OpenNuvoton/NuMaker_NuWicam_RDK/hardware_design/BOM/NUWICAM DEBUG BOM X 100.xls

NuWicam Debug BOM X 100
Item | Quantity | Reference | Part | Total
1 | 2 | C9,C8 | 20pF / 0603 | 200
2 | 1 | CB1 | 0.1uF / 0603 | 100
3 | 5 | C3,C5,C7,C10,C11 | 1uF / 0603 | 500
4 | 2 | C6,C4 | 10uF / 0603 | 200
5 | 2 | D2,D1 | RB161M-20 / SOD123 | 200
6 | 2 | R2,R4 | 0 / 0603 | 200
7 | 2 | R7,R8 | 27 / 0603 | 200
8 | 1 | R6 | 4.7K / 0603 | 100
9 | 1 | R5 | 10K / 0603 | 100
10 | 1 | R1 | 20K / 0603 | 100
11 | 1 | R3 | 39K / 0603 | 100
12 | 1 | J1 | HEADER 2X1 / 2.0mm_M | 100
13 | 1 | CON3 | HEADER 4X2 / 2.0mm_M | 100
14 | 2 | CON2,CON4 | USB-MINI-AB-RECEP. / SMD | 200
15 | 1 | U1 | NUC123ZD4AN0 / QFN33_5X5 | 100
16 | 1 | U2 | XC6206P332MR / SOT23 | 100
17 | 1 | X1 | 12MHz / TXC7m-3.2x2.5mm | 100
 | 15 |  |  | 1500
