OpenNuvoton/NuMaker_NuWicam_RDK/hardware_design/BOM/NUWICAM TVP BOM X 50.xls

NuWicam TVP BOM X 50
Item | Quantity | Reference | Part | Total
1 | 1 | C22 | 10pF / 0402 | 50
2 | 2 | C5,C6 | 12pF / 0402 | 100
3 | 2 | C21,C20 | 27pF / 0402 | 100
4 | 1 | C19 | 102pF / 0402 | 50
5 | 1 | C13 | 470pF / 0402 | 50
6 | 13 | CB1,C1,CB2,C2,CB3,C8,C9, | 0.1uF / 0402 | 650
 |  | C14,C15,C16,C17,C18,C25
7 | 6 | C7,CT8,C10,C11,C12,C4 | 1uF / 0402 | 300
8 | 14 | CT1,CT2,CT3,CT4,CT6,CT7, | 10uF / 0603 | 700
 |  | CT9,CT10,CT11,CT12,CT13,
 |  | CT14,CT15,CT16
9 | 6 | CT5 | 47uF / 0805 | 300
10 | 1 | LED1 | Ready LED / 0603 (Green) | 50
11 | 1 | LED2 | Link LED / 0603 (Red) | 50
12 | 1 | LED3 | Reserve LED / 0603 (Yellow) | 50
13 | 7 | L1,L4,L5,L6,L7,L8,L9 | FB / 0402 /10ohm 1A | 350
14 | 2 | L2,L3 | 4.7uH/1.1MHz / SMD | 100
15 | 3 | R32,R33,R17 | 0 / 0402 | 150
16 | 2 | R24,R30 | 22 / 0402 | 100
17 | 1 | R34 | 27 / 0402 | 50
18 | 1 | R23 | 47 / 0402 | 50
19 | 4 | R1,R2,R3,R10 | 1K / 0402 | 200
20 | 2 | R19,R20 | 1.2K / 0402 | 100
21 | 2 | R11,R15 | 3.3K / 0402 | 100
22 | 3 | R27,R31,R29 | 10K / 0402 | 150
23 | 1 | R13 | 12.1K 1% / 0402 | 50
24 | 1 | R9 | 47K / 0402 | 50
25 | 5 | R4,R5,R28,R12,R18 | 100K 1% / 0402 | 250
26 | 1 | R22 | 120K 1% / 0402 | 50
27 | 1 | R25 | 200K 1% / 0402 | 50
28 | 1 | R21 | 510K 1% / 0402 | 50
29 | 2 | R26,R8 | 1M / 0402 | 100
30 | 1 | J1 | RCA JACK | 50
31 | 1 | J2 | HEADER 2X1 / 2.0mm_M | 50
32 | 1 | CON1 | HEADER 4X1 / 2.54mm_M | 50
33 | 1 | CON2 | HEADER 4X2 / 2.0mm_F | 50
34 | 1 | SW1 | TPS-056 / SMD | 50
35 | 1 | ANT1 | IPEX_Connector / SMD | 50
36 | 1 | M1 | Microphone / 9.7D_2.54mm | 50
37 | 1 | Q1 | 2N3904 / SOT23-BEC | 50
38 | 1 | Q2 | SI2301CDS / SOT23-BEC | 50
39 | 1 | U1 | EN25Q64 / SOIC8 | 50
40 | 1 | U2 | N32905R3DN / TQFP64(EPAD) | 50
41 | 2 | U5,U3 | ZT7103T / TSOT-25 | 100
42 | 1 | U6 | RTL8189FTV / LGA_12mmx12mmx2mm | 50
43 | 1 | U4 | TVP5150 / LQFP32_7mmx7mm | 50
45 | 1 | X1 | 12MHz / TXC7m-3.2x2.5mm | 50
46 | 1 | X2 | 14.318MHz / TXC7m-3.2x2.5mm | 50
 | 58 |  |  | 2900
