OpenNuvoton/NuMaker_NuWicam_RDK/hardware_design/BOM/NUWICAM VGA BOM X 50.xls

NuWicam VGA BOM X 50
Item | Quantity | Reference | Part | Total
1 | 1 | C13 | 10pF / 0402 | 50
2 | 2 | C5,C6 | 12pF / 0402 | 100
3 | 1 | C12 | 102pF / 0402 | 50
4 | 1 | C10 | 470pF / 0402 | 50
5 | 9 | CB1,C1,CB2,C2,CB3,CB4,C8, | 0.1uF / 0402 | 450
 |  | C9,C11
6 | 3 | C7,CT8,C4 | 1uF / 0402 | 150
7 | 13 | CT1,CT2,CT3,CT4,CT6,CT7, | 10uF / 0603 | 650
 |  | CT9,CT10,CT11,CT12,CT13,
 |  | CT14,CT15
8 | 1 | CT5 | 47uF / 0805 | 50
9 | 1 | LED1 | Ready LED / 0603 (Green) | 50
10 | 1 | LED2 | Link LED / 0603 (Red) | 50
11 | 1 | LED3 | Reserve LED / 0603 (Yellow) | 50
12 | 5 | L1,L4,L5,L6,L7 | FB / 0402 /10ohm 1A | 250
13 | 2 | L2,L3 | 4.7uH/1.1MHz / SMD | 100
14 | 1 | R27 | 0 / 0402 | 50
15 | 2 | R20,R26 | 22 / 0402 | 100
16 | 4 | R1,R2,R3,R10 | 1K / 0402 | 200
17 | 2 | R21,R22 | 1.2K / 0402 | 100
18 | 2 | R15,R11 | 3.3K / 0402 | 100
19 | 1 | R25 | 10K / 0402 | 50
20 | 1 | R13 | 12.1K 1% / 0402 | 50
21 | 1 | R8 | 47K / 0402 | 50
22 | 5 | R4,R5,R24,R12,R17 | 100K 1% / 0402 | 250
23 | 1 | R19 | 120K 1% / 0402 | 50
24 | 1 | R23 | 200K 1% / 0402 | 50
25 | 1 | R18 | 510K 1% / 0402 | 50
26 | 1 | R9 | 1M / 0402 | 50
27 | 1 | CON1 | HEADER 4X1 / 2.54mm_M | 50
28 | 1 | CON2 | HEADER 4X2 / 2.0mm_F | 50
29 | 1 | SW1 | PTS-056 / SMD | 50
30 | 1 | ANT1 | IPEX_Connector / SMD | 50
31 | 1 | M1 | Microphone / 9.7D_2.54mm | 50
32 | 1 | Q1 | 2N3904 / SOT23-BEC | 50
33 | 1 | Q2 | SI2301CDS / SOT23-BEC | 50
34 | 1 | U1 | EN25Q64 / SOIC8 | 50
35 | 1 | U2 | N32905R3DN / TQFP64(EPAD) | 50
36 | 1 | U3 | FPC24_0.5mm | 50
37 | 2 | U4,U5 | ZT7103T / TSOT-25 | 100
38 | 1 | U6 | RTL8189FTV / LGA_12mmx12mmx2mm | 50
39 | 1 | X1 | 12MHz / TXC7m-3.2x2.5mm | 50
 | 47 |  |  | 2350
