OpenNuvoton/NuMaker_NuWicam_RDK/hardware_design/SMD_XY/NUCAM TVP_162.xls

PartType | RefDes | PartDecal | Pins | Layer | Orient. | X | Y | SMD | Glued
20279-001E-01 | ANT1 | ANT_3X3MM | 3 | Top | 90 | 155 | -150 | Yes | No
C0402 | C1 | C0402 | 2 | Top | 90 | 543.75 | -875 | Yes | No
C0402 | C2 | C0402 | 2 | Top | 270 | 284.4 | -1387.057 | Yes | No
C0402 | C4 | C0402 | 2 | Top | 270 | 762.102 | -1460.571 | Yes | No
C0402 | C5 | C0402 | 2 | Bottom | 90 | 481.25 | -675 | Yes | No
C0402 | C6 | C0402 | 2 | Bottom | 270 | 582 | -659.5 | Yes | No
C0402 | C7 | C0402 | 2 | Bottom | 0 | 900 | -1330 | Yes | No
C0402 | C8 | C0402 | 2 | Bottom | 90 | 858 | -1710 | Yes | No
C0402 | C9 | C0402 | 2 | Bottom | 90 | 810 | -1710 | Yes | No
C0402 | C10 | C0402 | 2 | Top | 0 | 212.5 | -1150 | Yes | No
C0402 | C11 | C0402 | 2 | Top | 0 | 212.5 | -1100 | Yes | No
C0402 | C12 | C0402 | 2 | Top | 90 | 284 | -1125 | Yes | No
C0402 | C13 | C0402 | 2 | Top | 90 | 737.5 | -631.25 | Yes | No
C0402 | C14 | C0402 | 2 | Top | 90 | 931.25 | -743.75 | Yes | No
C0402 | C15 | C0402 | 2 | Top | 0 | 268.75 | -1200 | Yes | No
C0402 | C16 | C0402 | 2 | Top | 90 | 281.25 | -1493.75 | Yes | No
C0402 | C17 | C0402 | 2 | Top | 0 | 410 | -1325 | Yes | No
C0402 | C18 | C0402 | 2 | Top | 90 | 485 | -875 | Yes | No
C0402 | C19 | C0402 | 2 | Bottom | 90 | 384 | -420 | Yes | No
C0402 | C20 | C0402 | 2 | Top | 90 | 396.9 | -1474.557 | Yes | No
C0402 | C21 | C0402 | 2 | Top | 270 | 618.75 | -1475 | Yes | No
C0402 | C22 | C0402 | 2 | Top | 0 | 335 | -150 | Yes | No
C0402 | C23 | C0402 | 2 | Top | 270 | 260 | -175 | Yes | No
C0402 | C24 | C0402 | 2 | Top | 270 | 410 | -175 | Yes | No
C0402 | C25 | C0402 | 2 | Bottom | 0 | 846 | -516 | Yes | No
C0402 | CB1 | C0402 | 2 | Bottom | 270 | 365.65 | -1468.307 | Yes | No
C0402 | CB2 | C0402 | 2 | Bottom | 90 | 684.4 | -812.057 | Yes | No
C0402 | CB3 | C0402 | 2 | Bottom | 180 | 825 | -987.5 | Yes | No
2.54MM_HEADER_1X4 | CON1 | SIP-4P | 4 | Top | 270 | 62.5 | -1190 | No | No
2.0MM_HEADER_2X4 | CON2 | HEADER4X2/2.0MM | 8 | Top | 270 | 87.5 | -775 | No | No
C0603 | CT1 | C0603 | 2 | Top | 90 | 636 | -864 | Yes | No
C0603 | CT2 | C0603 | 2 | Bottom | 270 | 428.15 | -1474.557 | Yes | No
C0603 | CT3 | C0603 | 2 | Bottom | 90 | 138 | -1158 | Yes | No
C0603 | CT4 | C0603 | 2 | Bottom | 180 | 837.5 | -1075 | Yes | No
C0805 | CT5 | C0805 | 2 | Top | 180 | 840 | -1615 | Yes | No
C0603 | CT6 | C0603 | 2 | Top | 90 | 210 | -870 | Yes | No
C0603 | CT7 | C0603 | 2 | Bottom | 90 | 850 | -1170 | Yes | No
C0402 | CT8 | C0402 | 2 | Bottom | 270 | 162.5 | -1268.75 | Yes | No
C0603 | CT9 | C0603 | 2 | Top | 0 | 875 | -606.25 | Yes | No
C0603 | CT10 | C0603 | 2 | Top | 0 | 868.75 | -1012.5 | Yes | No
C0603 | CT11 | C0603 | 2 | Bottom | 270 | 132 | -390 | Yes | No
C0603 | CT12 | C0603 | 2 | Bottom | 0 | 268.75 | -668.75 | Yes | No
C0603 | CT13 | C0603 | 2 | Top | 90 | 390 | -366 | Yes | No
C0603 | CT14 | C0603 | 2 | Top | 180 | 670 | -1255 | Yes | No
C0603 | CT15 | C0603 | 2 | Top | 180 | 265 | -1260 | Yes | No
C0603 | CT16 | C0603 | 2 | Bottom | 0 | 845 | -447 | Yes | No
RCA-JACK1 | J1 | RCA-JACK1 | 4 | Top | 270 | 312.5 | -1637.5 | No | No
2.0MM | J2 | HEADER2/2.0MM | 2 | Top | 0 | 666 | -1602 | No | No
L0402 | L1 | L0402 | 2 | Bottom | 270 | 920 | -1205 | Yes | No
SMTDR43 | L2 | SMTDR43 | 2 | Top | 270 | 868.75 | -900 | Yes | No
SMTDR43 | L3 | SMTDR43 | 2 | Bottom | 270 | 243.75 | -556.25 | Yes | No
L0402 | L4 | L0402 | 2 | Top | 270 | 700 | -1335 | Yes | No
L0402 | L5 | L0402 | 2 | Top | 180 | 235 | -1315 | Yes | No
L0402 | L6 | L0402 | 2 | Top | 180 | 300 | -378 | Yes | No
L0402 | L7 | L0402 | 2 | Bottom | 90 | 920 | -1110 | Yes | No
L0402 | L8 | L0402 | 2 | Bottom | 90 | 747 | -1614 | Yes | No
L0402 | L9 | L0402 | 2 | Top | 90 | 942 | -1524 | Yes | No
LED_0603 | LED1 | LED_0603 | 2 | Top | 270 | 362.5 | -600 | Yes | No
LED_0603 | LED2 | LED_0603 | 2 | Top | 270 | 288 | -600 | Yes | No
LED_0603 | LED3 | LED_0603 | 2 | Top | 270 | 216 | -600 | Yes | No
5.5D2.54MM | M1 | 9.7D2.54MM | 2 | Top | 180 | 834 | -1788 | No | No
SOT23-BCE | Q1 | SOT23 | 3 | Bottom | 90 | 852 | -1458 | Yes | No
SOT-23-GSD | Q2 | SOT23-GSD | 3 | Top | 0 | 84 | -1032 | Yes | No
R0402 | R1 | R0402 | 2 | Top | 270 | 362.5 | -481.25 | Yes | No
R0402 | R2 | R0402 | 2 | Top | 270 | 281.25 | -481.25 | Yes | No
R0402 | R3 | R0402 | 2 | Top | 270 | 200 | -481.25 | Yes | No
R0402 | R4 | R0402 | 2 | Top | 270 | 170 | -1340 | Yes | No
R0402 | R5 | R0402 | 2 | Top | 270 | 234.4 | -1387.057 | Yes | No
R0402 | R8 | R0402 | 2 | Top | 0 | 525 | -762.5 | Yes | No
R0402 | R9 | R0402 | 2 | Top | 90 | 816 | -1452 | Yes | No
R0402 | R10 | R0402 | 2 | Top | 270 | 942 | -1614 | Yes | No
R0402 | R11 | R0402 | 2 | Bottom | 270 | 906 | -1710 | Yes | No
R0402 | R12 | R0402 | 2 | Bottom | 180 | 900 | -1280 | Yes | No
R0402 | R13 | R0402 | 2 | Top | 270 | 725 | -862.5 | Yes | No
R0402 | R15 | R0402 | 2 | Bottom | 90 | 762 | -1710 | Yes | No
R0402 | R17 | R0402 | 2 | Top | 180 | 243.75 | -1056.25 | Yes | No
R0402 | R18 | R0402 | 2 | Top | 90 | 881.25 | -743.75 | Yes | No
R0402 | R19 | R0402 | 2 | Top | 270 | 435 | -870 | Yes | No
R0402 | R20 | R0402 | 2 | Top | 270 | 385 | -870 | Yes | No
R0402 | R21 | R0402 | 2 | Top | 90 | 787.5 | -631.25 | Yes | No
R0402 | R22 | R0402 | 2 | Top | 270 | 687.5 | -637.5 | Yes | No
R0402 | R23 | R0402 | 2 | Top | 270 | 231.25 | -1487.5 | Yes | No
R0402 | R24 | R0402 | 2 | Top | 0 | 271.9 | -999.557 | Yes | No
R0402 | R25 | R0402 | 2 | Bottom | 270 | 330 | -420 | Yes | No
R0402 | R26 | R0402 | 2 | Top | 0 | 509.4 | -1349.557 | Yes | No
R0402 | R27 | R0402 | 2 | Bottom | 90 | 666 | -1524 | Yes | No
R0402 | R28 | R0402 | 2 | Top | 180 | 210 | -378 | Yes | No
R0402 | R29 | R0402 | 2 | Top | 270 | 420 | -531 | Yes | No
R0402 | R30 | R0402 | 2 | Top | 270 | 418.75 | -737.5 | Yes | No
R0402 | R31 | R0402 | 2 | Top | 270 | 700 | -1175 | Yes | No
R0402 | R32 | R0402 | 2 | Top | 180 | 625 | -1315 | Yes | No
R0402 | R33 | R0402 | 2 | Top | 270 | 324 | -306 | Yes | No
R0402 | R34 | R0402 | 2 | Top | 270 | 335 | -1495 | Yes | No
PTS-056 | SW1 | SW4\3.5X3.55MM | 7 | Top | 270 | 915 | -1371 | No | No
SOIC8_208MIL | U1 | SOIC-8P_208MIL | 8 | Bottom | 270 | 862.5 | -762.5 | Yes | No
LQFP64_EPAD | U2 | QFP64/12/0.5MM/EP | 69 | Bottom | 180 | 484.4 | -1112.057 | Yes | No
TSOT-23-5 | U3 | TSOT-25 | 5 | Top | 0 | 793.75 | -743.75 | Yes | No
LQFP32_7X7 | U4 | PQFP-32 | 32 | Top | 90 | 484.4 | -1112.057 | Yes | No
TSOT-23-5 | U5 | TSOT-25 | 5 | Bottom | 0 | 237.5 | -400 | Yes | No
LGA_12X12X1.8 | U6 | LGA44_12_12MM | 45 | Top | 0 | 692.5 | -293.504 | Yes | No
QFN32_5X5 | U7 | GM7150-QFN32-5X5 | 33 | Top | 0 | 484.4 | -1112.057 | Yes | No
TXC7M-3.2X2.5MM | X1 | SMD3225 | 4 | Top | 0 | 525 | -668.75 | Yes | No
TXC7M-3.2X2.5MM | X2 | SMD3225 | 4 | Top | 0 | 509.4 | -1474.557 | Yes | No
