OpenNuvoton/NuMaker_NuWicam_RDK/hardware_design/SMD_XY/NUWICAM DEBUG.xls

PartType | RefDes | PartDecal | Pins | Layer | Orient. | X | Y | SMD | Glued
C0603 | C1 | C0603 | 2 | Top | 270 | 270 | 300 | Yes | No
C0603 | C2 | C0603 | 2 | Top | 90 | 480 | 300 | Yes | No
C0603 | C3 | C0603 | 2 | Top | 180 | 485 | 120 | Yes | No
C0603 | C4 | C0603 | 2 | Bottom | 180 | 487.5 | 150 | Yes | No
C0603 | C5 | C0603 | 2 | Top | 270 | 706.25 | 241.25 | Yes | No
C0603 | C6 | C0603 | 2 | Top | 270 | 631.25 | 241.25 | Yes | No
C0603 | C7 | C0603 | 2 | Top | 270 | 785 | 365 | Yes | No
C0603 | C8 | C0603 | 2 | Bottom | 180 | 962.5 | 185 | Yes | No
C0603 | C9 | C0603 | 2 | Bottom | 0 | 962.5 | 441.25 | Yes | No
C0603 | C10 | C0603 | 2 | Bottom | 90 | 1182 | 672 | Yes | No
C0603 | C11 | C0603 | 2 | Bottom | 270 | 960 | 678 | Yes | No
C0603 | CB1 | C0603 | 2 | Top | 180 | 956.25 | 397.5 | Yes | No
CONS/5X1/2.54 | CON1 | SIP-5P | 5 | Bottom | 0 | 912.5 | 50 | Yes | No
MINI_5P_B_TYPE | CON2 | MINI_5P_B_TYPE | 11 | Top | 0 | 415 | 485 | No | No
2.0MM_HEADER_2X4_A | CON3 | HEADER4X2/2.0MM_A | 8 | Bottom | 270 | 1161.417 | 393.701 | No | No
MINI_5P_B_TYPE | CON4 | MINI_5P_B_TYPE | 11 | Bottom | 270 | 306.25 | 81.25 | No | No
SOD-123 | D1 | MLL34 | 2 | Bottom | 0 | 243.75 | 712.5 | Yes | No
SOD-123 | D2 | MLL34 | 2 | Top | 180 | 270 | 85 | Yes | No
2.0MM | J1 | HEADER2/2.0MM | 2 | Top | 270 | 660 | 714 | No | No
R0603 | R1 | R0603 | 2 | Bottom | 180 | 395 | 710 | Yes | No
R0603 | R2 | R0603 | 2 | Top | 270 | 410 | 300 | Yes | No
R0603 | R3 | R0603 | 2 | Bottom | 180 | 395 | 635 | Yes | No
R0603 | R4 | R0603 | 2 | Top | 270 | 340 | 300 | Yes | No
R0603 | R5 | R0603 | 2 | Top | 270 | 785 | 240 | Yes | No
R0603 | R6 | R0603 | 2 | Bottom | 180 | 792 | 714 | Yes | No
R0603 | R7 | R0603 | 2 | Bottom | 180 | 475 | 220 | Yes | No
R0603 | R8 | R0603 | 2 | Bottom | 180 | 475 | 295 | Yes | No
QFN33_5X5 | U1 | QFN_32 | 33 | Bottom | 90 | 718.75 | 328.75 | Yes | No
SOT-23 | U2 | SOT23 | 3 | Bottom | 180 | 1075 | 700 | Yes | No
TXC7M-3.2X2.5MM | X1 | SMD3225 | 4 | Bottom | 90 | 965 | 320 | Yes | No
