OpenNuvoton/NuMaker_NuWicam_RDK/hardware_design/PCB/NUWICAM DEBUG.pdf

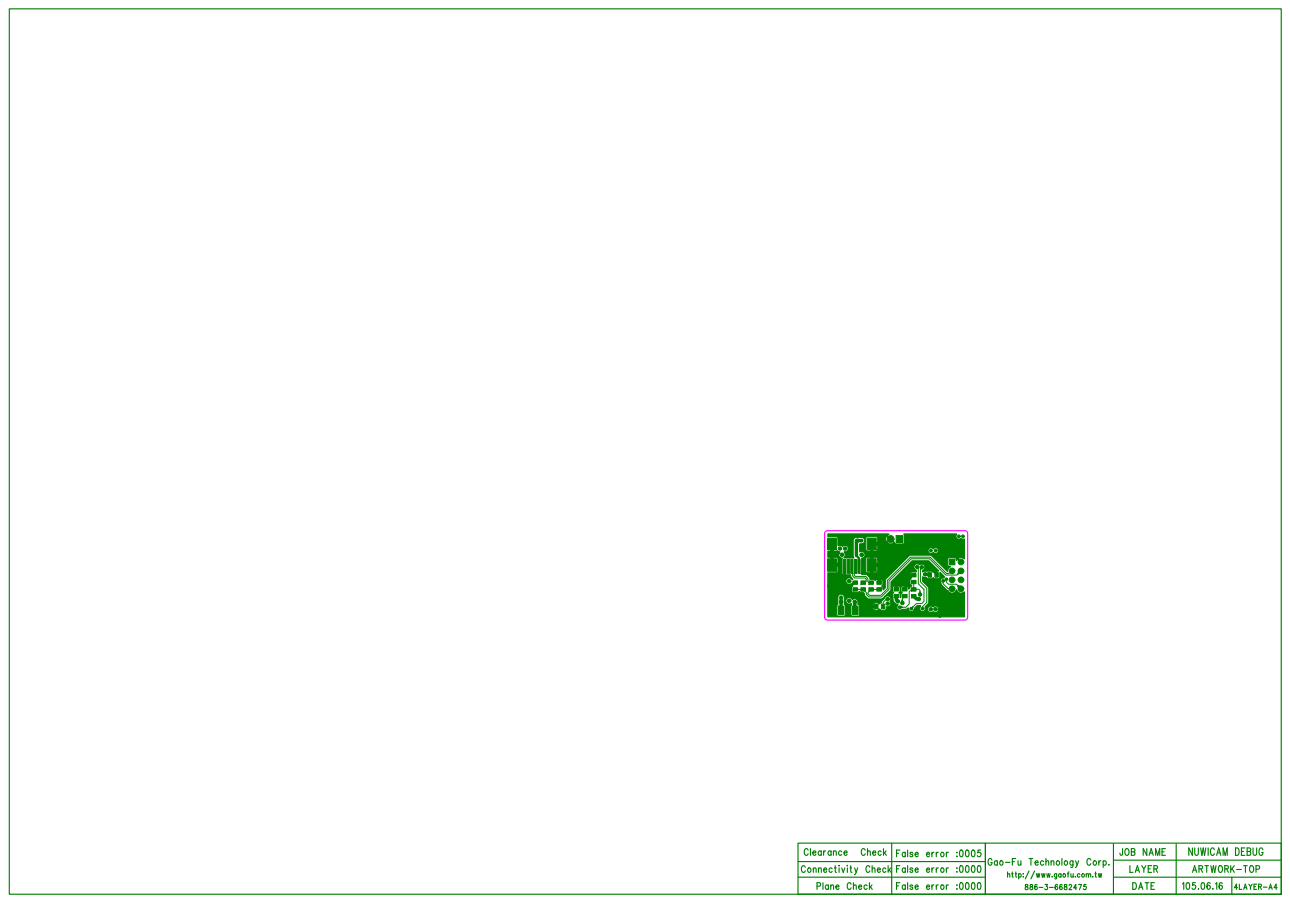
[picture p28: page 1]
http://www.gaofu.com.tw; ARTWORK-TOP; DATE; LAYER; JOB NAME; False error :0000; 4LAYER-A4; False error :0005; Connectivity Check; Clearance Check; Plane Check; NUWICAM DEBUG; R4R⁴x1 R⁴x2; CON2 CON²x5; CON²x4; CON²x3; CON²x2; CON²x1 CON²x6 CON²x7; CON²x8 CON²x9CON²x10; CON²x11; C3C³x2; C³x1; C2C²x1 C²x2; C6C⁶x1 C⁶x2; R5R⁵x1 R⁵x2; C1C¹x1 C¹x2; C5C⁵x1 C⁵x2; C7C⁷x1 C⁷x2; CB1 CB¹x2; CB¹x1; CON4 CON⁴x10 CON⁴x11; R2R²x1 R²x2; D2D²x2; D²x1; CON3 CON³x1 CON³x2 CON³x3 CON³x4 CON³x5 CON³x6 CON³x7 CON³x8

Gao-Fu Technology Corp.

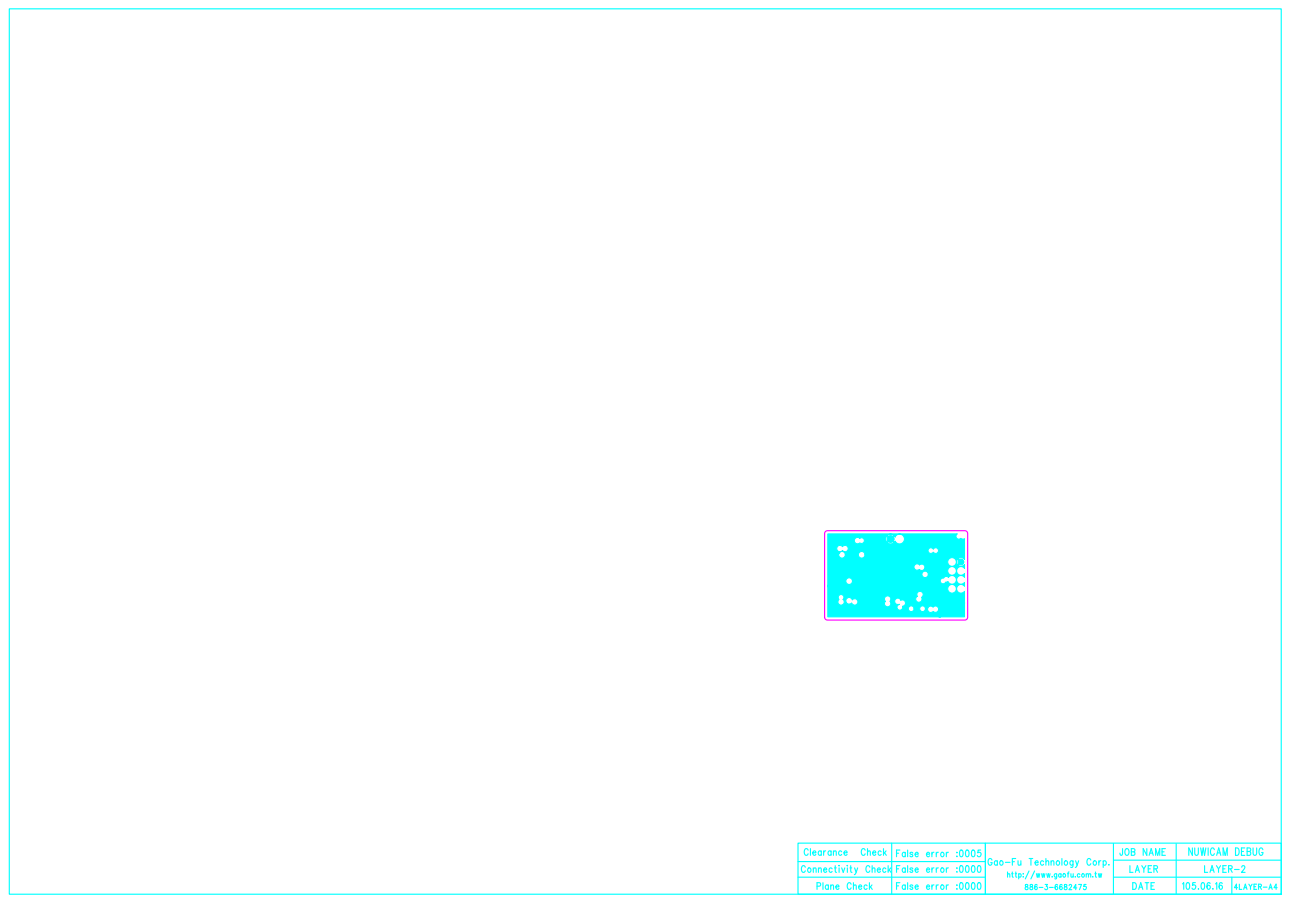
[picture p29: page 2]
CON2 CON²x10; CON²x11; CON4 CON⁴x10 CON⁴x11; CON3 CON³x1 CON³x2 CON³x3 CON³x4 CON³x5 CON³x6 CON³x7 CON³x8

Clearance Check | False error :0005 | °ª¤Ò¬ì§Þ(ªÑ)¤½¥q Gao-Fu Technology Corp. http://www.gaofu.com.tw 886-3-6682475 | JOB NAME | NUWICAM DEBUG
Connectivity Check | False error :0000 | | LAYER | LAYER-2
Plane Check | False error :0000 | | DATE | 105.06.16 | 4LAYER-A4

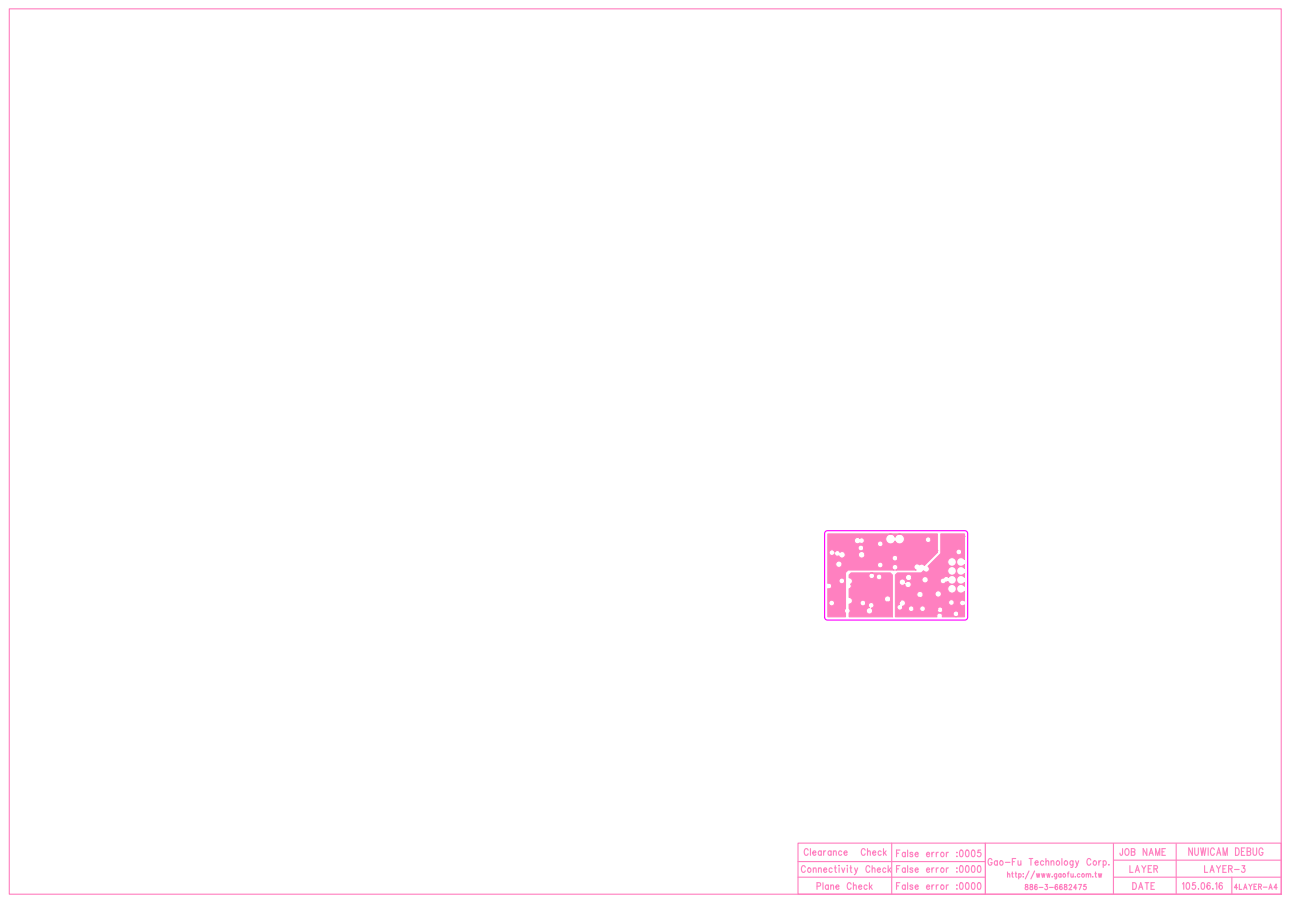
[picture p30: page 3]
CON2 CON²x10; CON²x11; CON4 CON⁴x10 CON⁴x11; CON3 CON³x1 CON³x2 CON³x3 CON³x4 CON³x5 CON³x6 CON³x7 CON³x8

Clearance Check | False error :0005 | °ª¤Ò¬ì§Þ(ªÑ)¤½¥q Gao-Fu Technology Corp. http://www.gaofu.com.tw 886-3-6682475 | JOB NAME | NUWICAM DEBUG
Connectivity Check | False error :0000 | | LAYER | LAYER-3
Plane Check | False error :0000 | | DATE | 105.06.16 | 4LAYER-A4

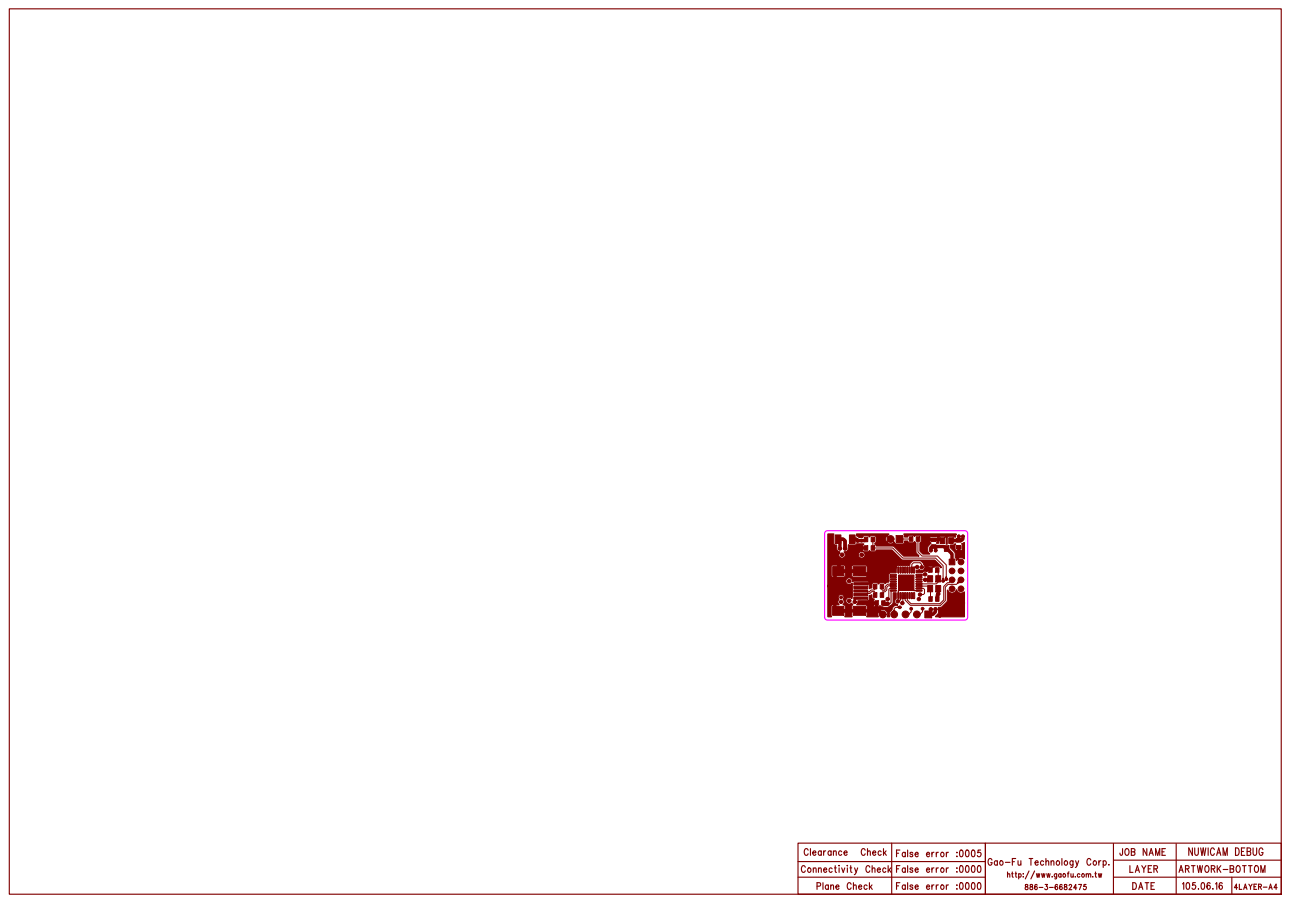
[picture p31: page 4]
CON2 CON²x10; CON²x11; C4C⁴x1; C⁴x2; R3R³x1; R³x2 R8R⁸x1; R⁸x2 J1J1x2 J1x1; C8C⁸x1; C⁸x2; C9C⁹x2; C⁹x1; CON4CON⁴x1 CON⁴x2 CON⁴x3 CON⁴x4 CON⁴x5 CON⁴x6; CON⁴x7 CON⁴x8; CON⁴x9 CON⁴x10 CON⁴x11; U1U¹x8 U¹x7 U¹x6 U¹x5 U¹x4 U¹x3 U¹x2 U¹x1 U¹x9 U¹x10 U¹x11 U¹x12 U¹x13 U¹x14 U¹x15 U¹x16; U¹x17 U¹x18 U¹x19 U¹x20 U¹x21 U¹x22 U¹x23 U¹x24; U¹x25 U¹x26 U¹x27 U¹x28 U¹x29 U¹x30 U¹x31 U¹x33 U¹x32; R1R¹x1; R¹x2; R6R⁶x1; R⁶x2; R7R⁷x1; R⁷x2; D1D¹x2; D¹x1; X1X¹x1 X¹x2; X¹x3 X¹x4; CON1 CON¹x5; CON¹x4; CON¹x3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

Clearance Check | False error :0005 | °ª¤Ò¬ì§Þ(ªÑ)¤½¥q http://www.gaofu.com.tw 886-3-6682475 | JOB NAME | NUWICAM DEBUG
Connectivity Check | False error :0000 | | LAYER | ARTWORK-BOTTOM Gao-Fu Technology Corp.
Plane Check | False error :0000 | | DATE | 105.06.16 | 4LAYER-A4

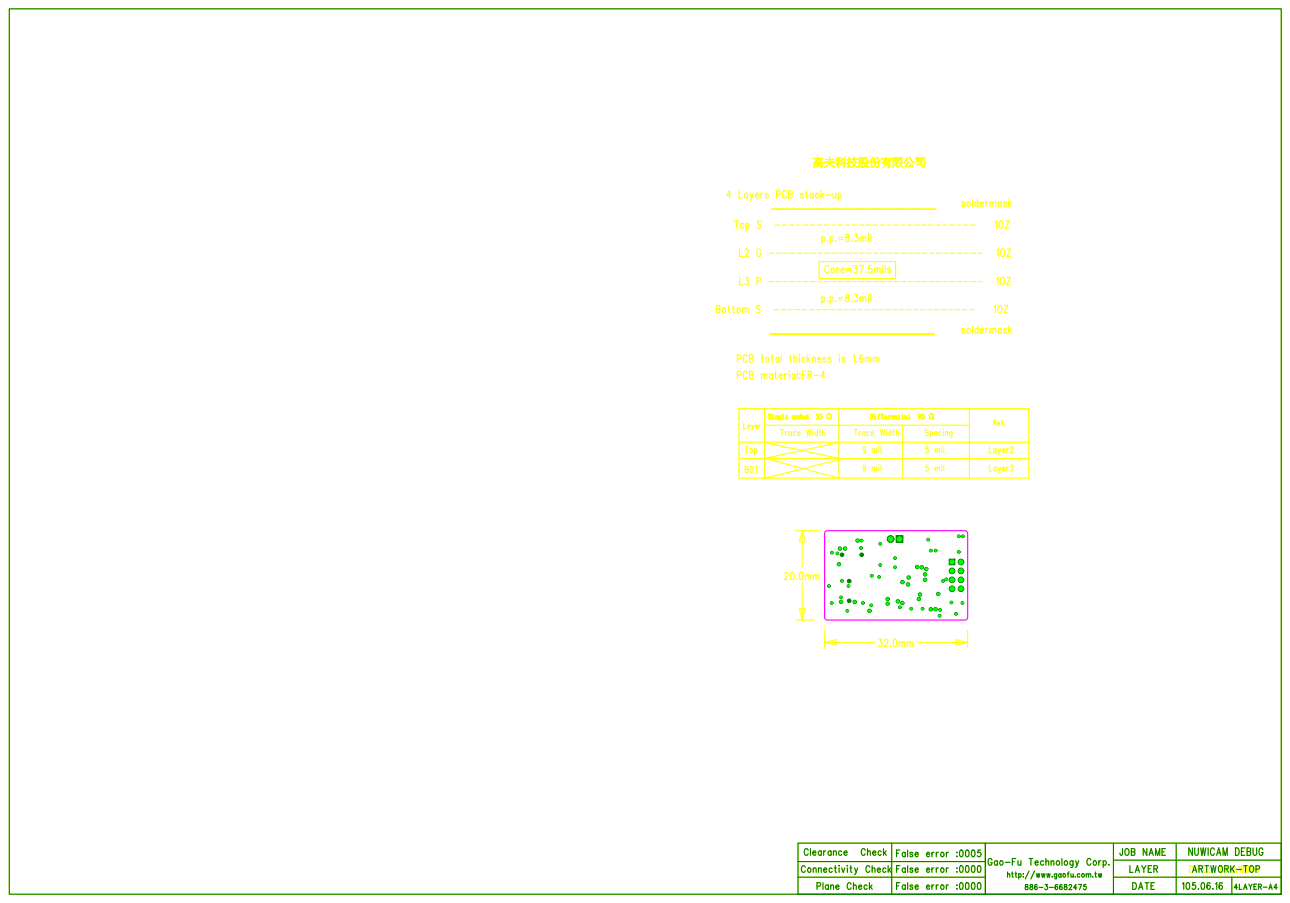
[picture p32: page 5]
http://www.gaofu.com.tw; DRILL DRAWING; DATE; LAYER; JOB NAME; False error :0000; 4LAYER-A4; False error :0005; Connectivity Check; Clearance Check; Plane Check; NUWICAM DEBUG; Top S ----------------------------- 1OZ; Bottom S ----------------------------- 1OZ; Core=37.5mils; p.p.=8.3mil; L3 P ------------------------------- 1OZ p.p.=8.3mil; soldermask; _____________________________ soldermask; °ª¤Ò¬ì§ÞªÑ¥÷¦³--¤½¥q; ARTWORK-TOP; CON3 CON³x1 CON³x2 CON³x3 CON³x4 CON³x5 CON³x6; CON3x7; CON3x8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

4 Layers PCB stack-up

PCB total thickness is 1.6mm
PCB material:FR-4

Single ended 50 £[ | Differential 90 £[ | Ref. Layer
Differential 90 £[ Trace Width | Trace Width | Spacing
Top | | 9 mil | 5 mil | Layer2
BOT | | 9 mil | 5 mil | Layer3

Gao-Fu Technology Corp.

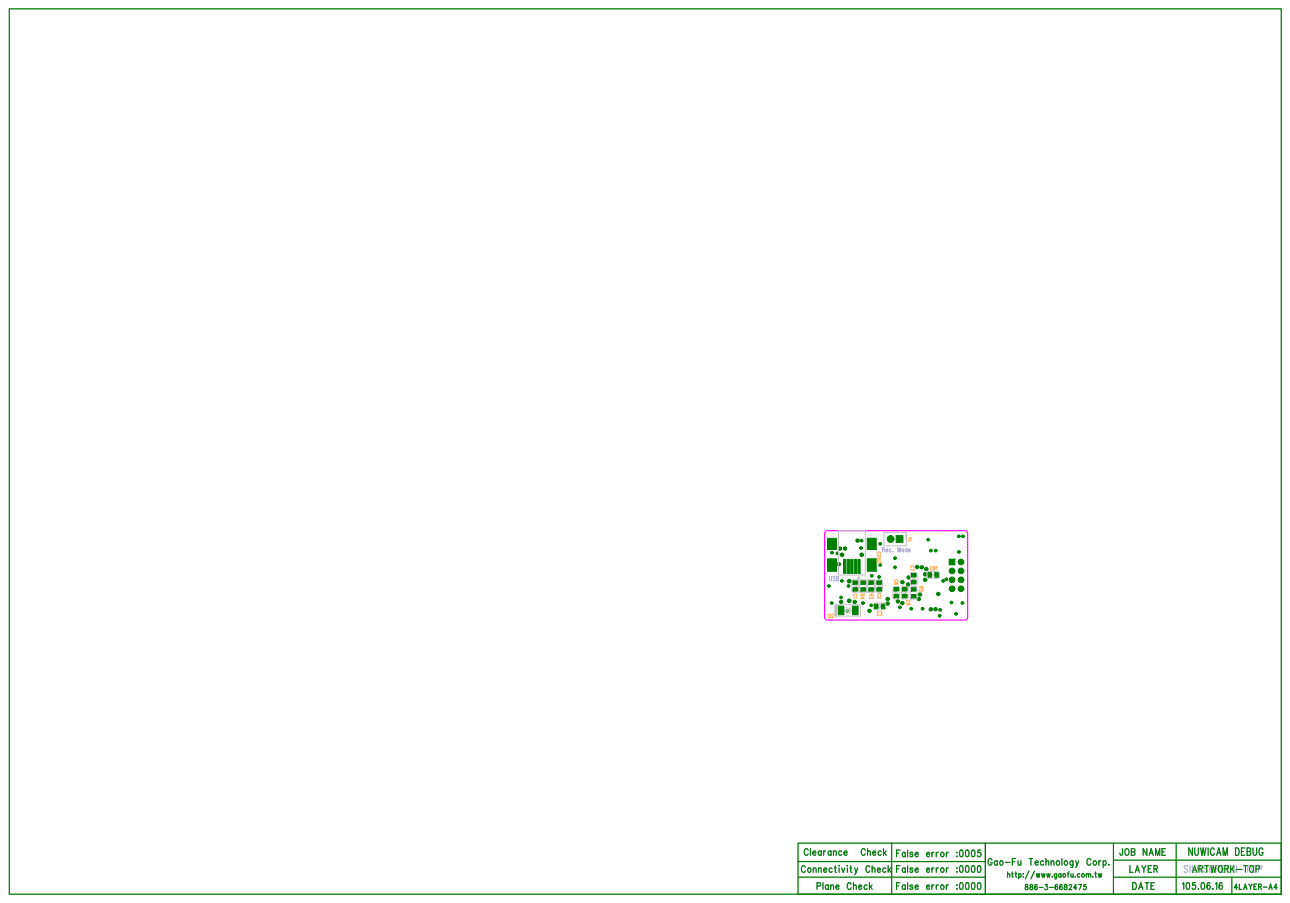
[picture p33: page 6]

Gao-Fu Technology Corp.

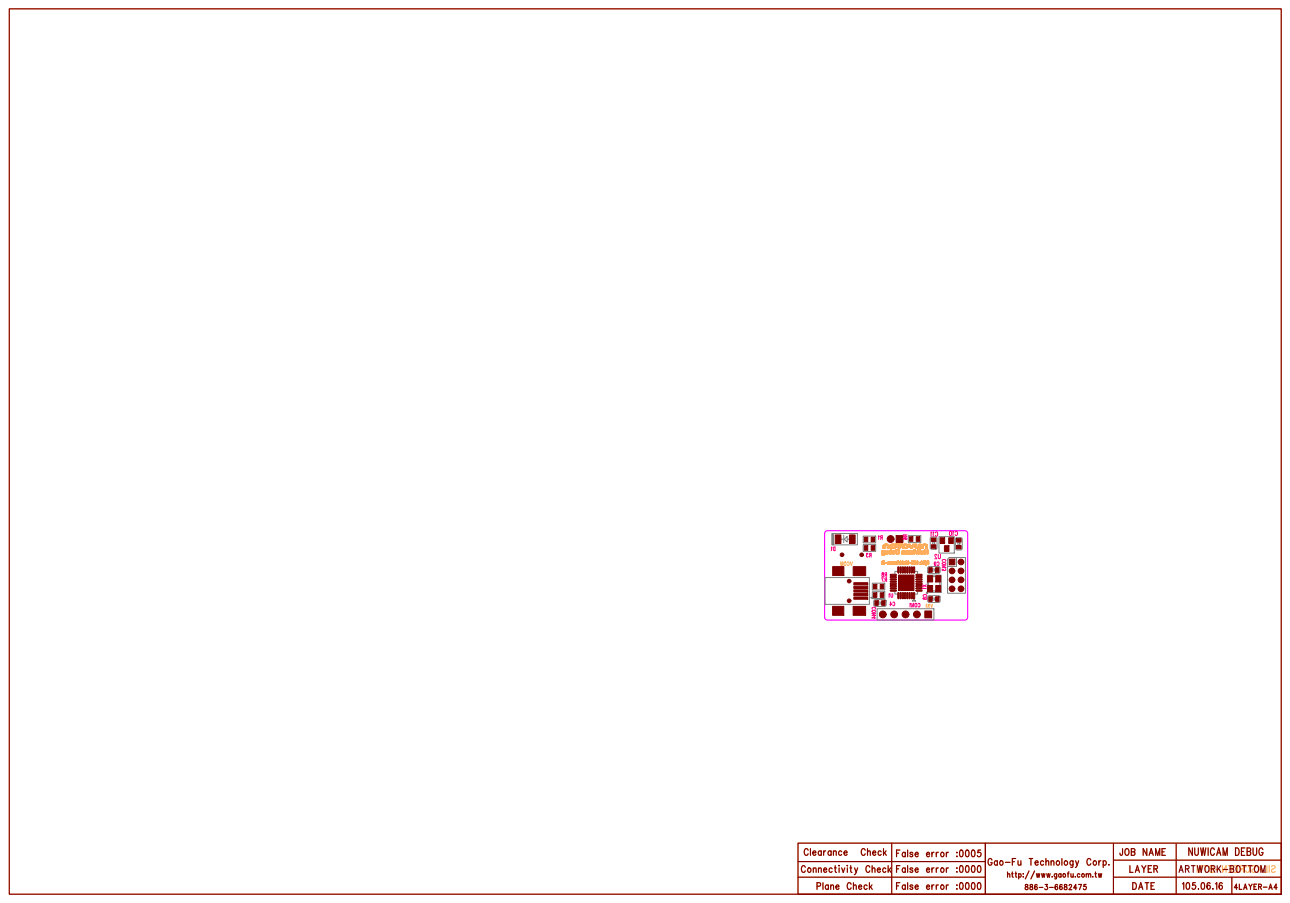
[picture p34: page 7]
CON4; CON3CON2 CON2x10 CON2x11 C4C4x1 C4x2; R3R³x1; R³x2 R8R⁸x1; R⁸x2 J1J1x2 J1x1; C8C⁸x1; C⁸x2; C9C⁹x2; C⁹x1; CON4CON⁴x1 CON⁴x2 CON⁴x3 CON⁴x4 CON⁴x5 CON⁴x6; CON⁴x7 CON⁴x8; CON⁴x9 CON⁴x10 CON⁴x11; U1U¹x8 U¹x7 U¹x6 U¹x5 U¹x4 U¹x3 U¹x2 U¹x1 U¹x9 U¹x10 U¹x11 U¹x12 U¹x13 U¹x14 U¹x15 U¹x16; U¹x17 U¹x18 U¹x19 U¹x20 U¹x21 U¹x22 U¹x23 U¹x24 U¹x25 U¹x26 U¹x27 U¹x28 U¹x29 U¹x30 U¹x31 U¹x33 U¹x32; R1R¹x1; R¹x2; R6R⁶x1; R⁶x2; R7R⁷x1; R⁷x2; D1D¹x2; D¹x1; X1X¹x1 X¹x2; X¹x3 X¹x4; CON1 CON¹x5; CON¹x4; CON¹x3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

Clearance Check | False error :0005 | °ª¤Ò¬ì§Þ(ªÑ)¤½¥q °ª¤Ò¬ì§Þ(ªÑ)¤½¥q Gao-Fu Technology Corp. http://www.gaofu.com.twhttp://www.gaofu.com.tw 886-3-6682475 886-3-6682475 | JOB NAME | NUWICAM DEBUG
Connectivity Check | False error :0000 | | LAYER | ARTWORK-BOTTOM Gao-Fu Technology Corp. SILKSCREEN-BTM
Plane Check | False error :0000 | | DATE | 105.06.16 | 4LAYER-A4

# R4R⁴x1 R⁴x2

CON2 CON²x5 | CON²x4 | CON²x3 | CON²x2 | CON²x1 CON²x6 CON²x7 | CON²x8 CON²x9CON²x10 | CON²x11 | C3C³x2 | C³x1
C2C²x1 C²x2 | C6C⁶x1 C⁶x2 | R5R⁵x1 R⁵x2

J1J1x2 J1x1

# C1C¹x1 C¹x2

C5C⁵x1 C⁵x2 | C7C⁷x1 C⁷x2
CB1 CB¹x2 | CB¹x1
CON4 CON⁴x10 CON⁴x11 | R2R²x1 R²x2
D2D²x2 | D²x1

# CON3 CON³x1 CON³x2 CON³x3 CON³x4 CON³x5 CON³x6 CON³x7 CON³x8

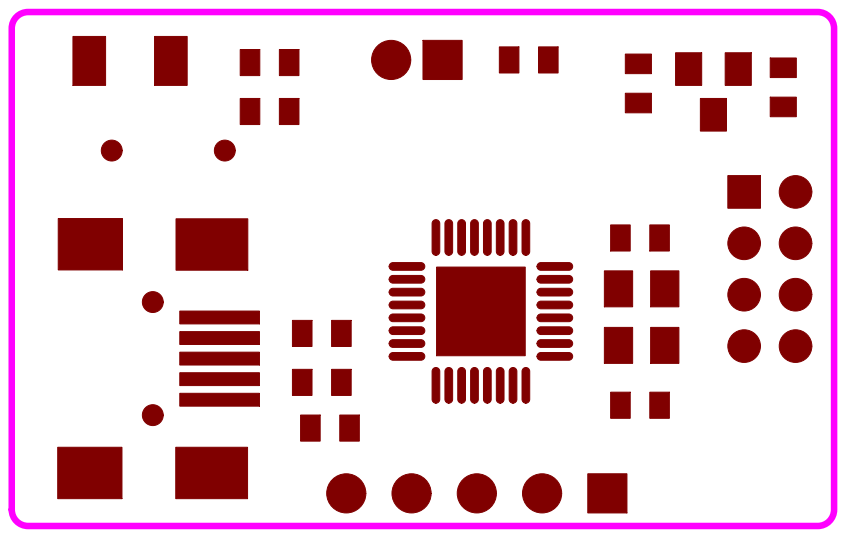
[picture p35: page 9]
CON2 CON²x10; CON²x11; C4C⁴x1; C⁴x2; R3R³x1; R³x2 R8R⁸x1; R⁸x2 J1J1x2 J1x1; C8C⁸x1; C⁸x2; C9C⁹x2; C⁹x1; CON4CON⁴x1 CON⁴x2 CON⁴x3 CON⁴x4 CON⁴x5 CON⁴x6; CON⁴x7 CON⁴x8; CON⁴x9 CON⁴x10 CON⁴x11; U1U¹x8 U¹x7 U¹x6 U¹x5 U¹x4 U¹x3 U¹x2 U¹x1 U¹x9 U¹x10 U¹x11 U¹x12 U¹x13 U¹x14 U¹x15 U¹x16; U¹x17 U¹x18 U¹x19 U¹x20 U¹x21 U¹x22 U¹x23 U¹x24; U¹x25 U¹x26 U¹x27 U¹x28 U¹x29 U¹x30 U¹x31 U¹x33 U¹x32; R1R¹x1; R¹x2; R6R⁶x1; R⁶x2; R7R⁷x1; R⁷x2; D1D¹x2; D¹x1; X1X¹x1 X¹x2; X¹x3 X¹x4; CON1 CON¹x5; CON¹x4; CON¹x3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

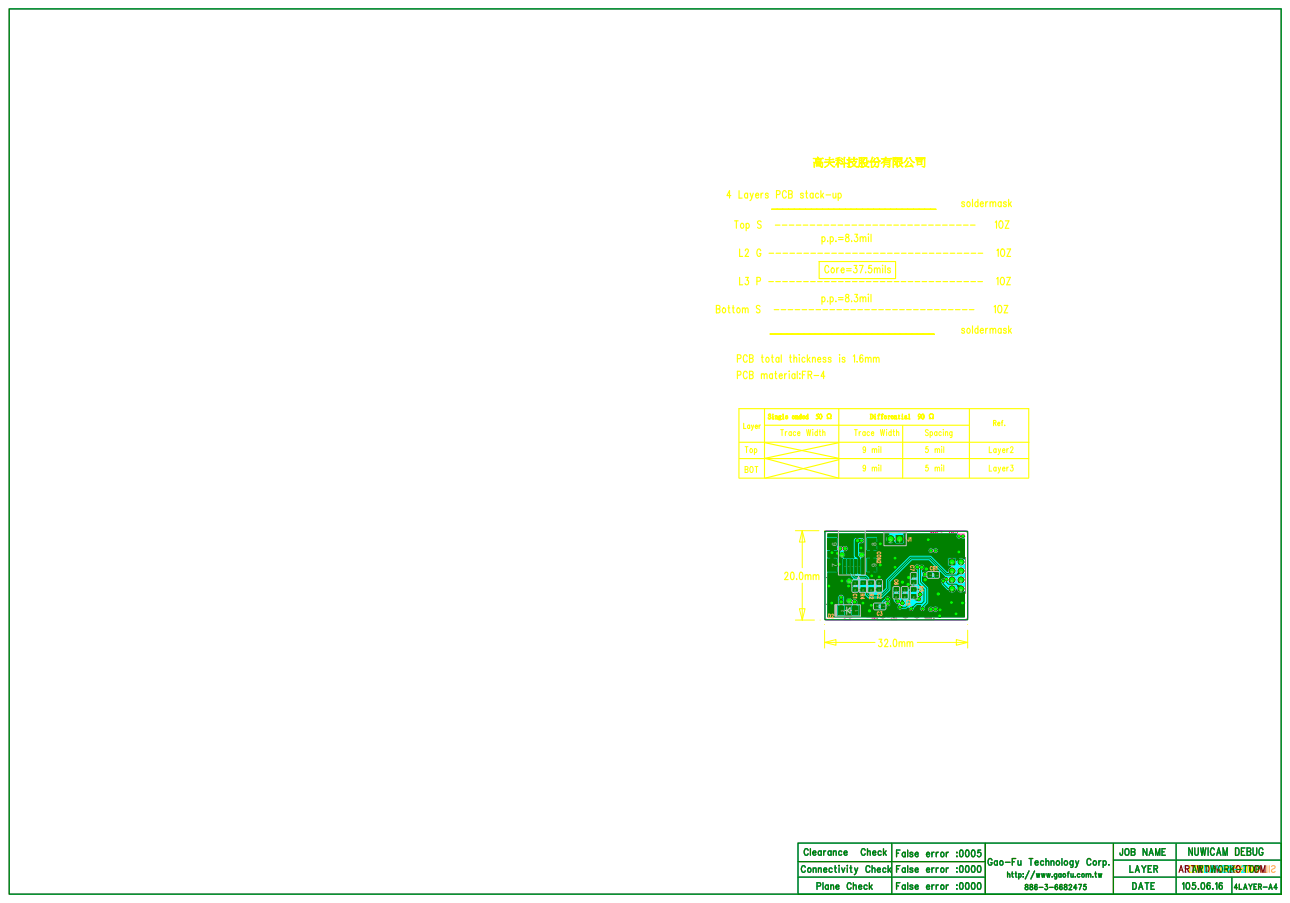
[picture p36: page 10]

4 Layers PCB stack-up

PCB total thickness is 1.6mm
PCB material:FR-4

Clearance Check Clearance Check Clearance Check Clearance Check Clearance Check Clearance Check Clearance Check | False error :0005 False error :0005 False error :0005 False error :0005 False error :0005 False error :0005 False error :0005 | °ª¤Ò¬ì§Þ(ªÑ)¤½¥q °ª¤Ò¬ì§Þ(ªÑ)¤½¥q °ª¤Ò¬ì§Þ(ªÑ)¤½¥q °ª¤Ò¬ì§Þ(ªÑ)¤½¥q °ª¤Ò¬ì§Þ(ªÑ)¤½¥q °ª¤Ò¬ì§Þ(ªÑ)¤½¥q °ª¤Ò¬ì§Þ(ªÑ)¤½¥q Gao-Fu Technology Corp. Gao-Fu Technology Corp. Gao-Fu Technology Corp. Gao-Fu Technology Corp. Gao-Fu Technology Corp. Gao-Fu Technology Corp. http://www.gaofu.com.twhttp://www.gaofu.com.twhttp://www.gaofu.com.twhttp://www.gaofu.com.twhttp://www.gaofu.com.twhttp://www.gaofu.com.twhttp://www.gaofu.com.tw 886-3-6682475 886-3-6682475 886-3-6682475 886-3-6682475 886-3-6682475 886-3-6682475 886-3-6682475 | JOB NAME JOB NAME JOB NAME JOB NAME JOB NAME JOB NAME JOB NAME | NUWICAM DEBUG NUWICAM DEBUG NUWICAM DEBUG NUWICAM DEBUG NUWICAM DEBUG NUWICAM DEBUG NUWICAM DEBUG
Connectivity Check Connectivity Check Connectivity Check Connectivity Check Connectivity Check Connectivity Check Connectivity Check | False error :0000 False error :0000 False error :0000 False error :0000 False error :0000 False error :0000 False error :0000 | | LAYER LAYER LAYER LAYER LAYER LAYER LAYER | ARTWORK-BOTTOM Gao-Fu Technology Corp. SILKSCREEN-TOP DRILL DRAWING ARTWORK-TOP LAYER-3 LAYER-2 SILKSCREEN-BTM
Plane Check Plane Check Plane Check Plane Check Plane Check Plane Check Plane Check | False error :0000 False error :0000 False error :0000 False error :0000 False error :0000 False error :0000 False error :0000 | | DATE DATE DATE DATE DATE DATE DATE | 105.06.16 105.06.16 105.06.16 105.06.16 105.06.16 105.06.16 105.06.16 | 4LAYER-A4 4LAYER-A4 4LAYER-A4 4LAYER-A4 4LAYER-A4 4LAYER-A4 4LAYER-A4
