OpenNuvoton/NuMaker_NuWicam_RDK/hardware_design/PCB/NUCAM TVP_162.pdf

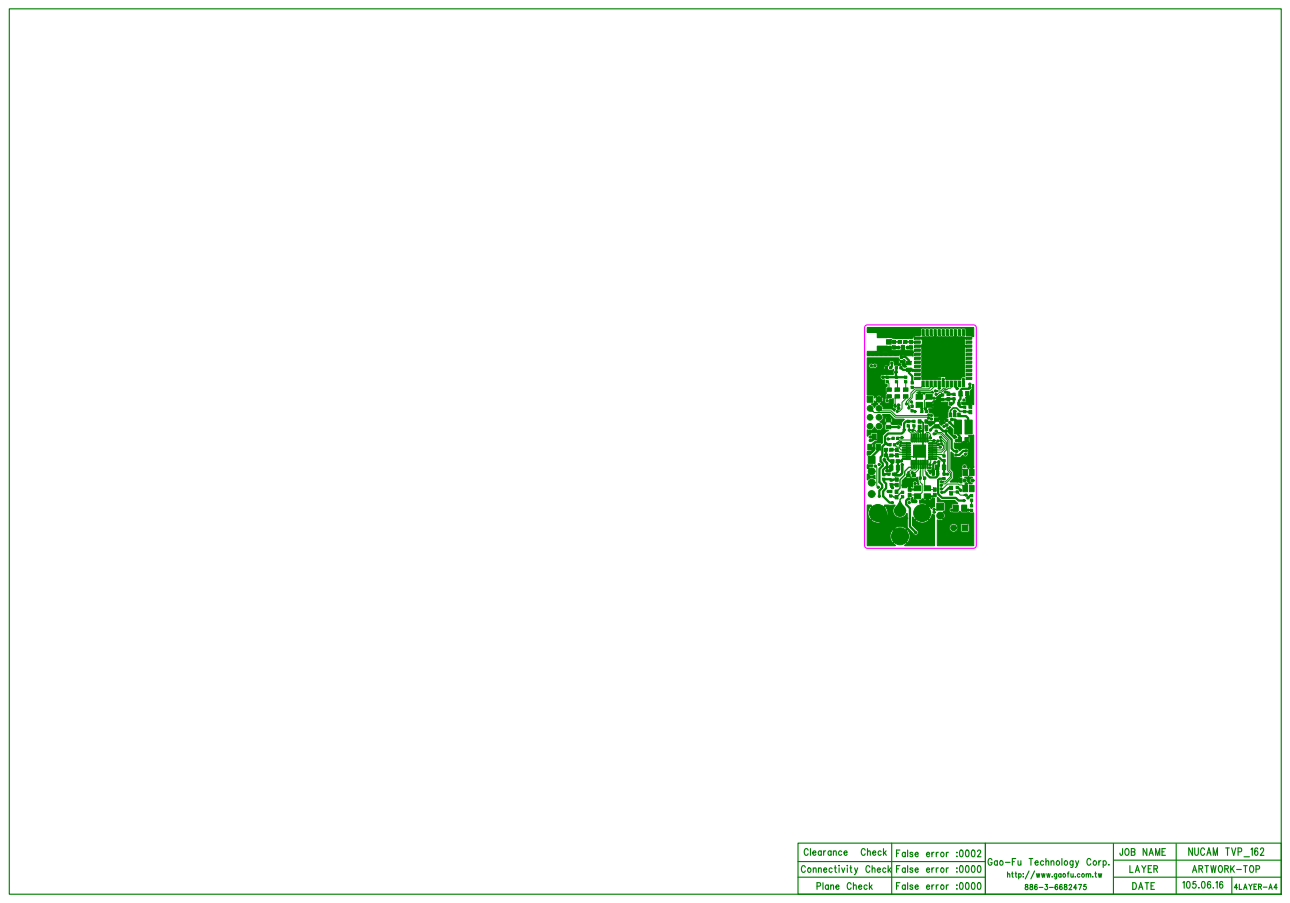
[picture p37: page 1]

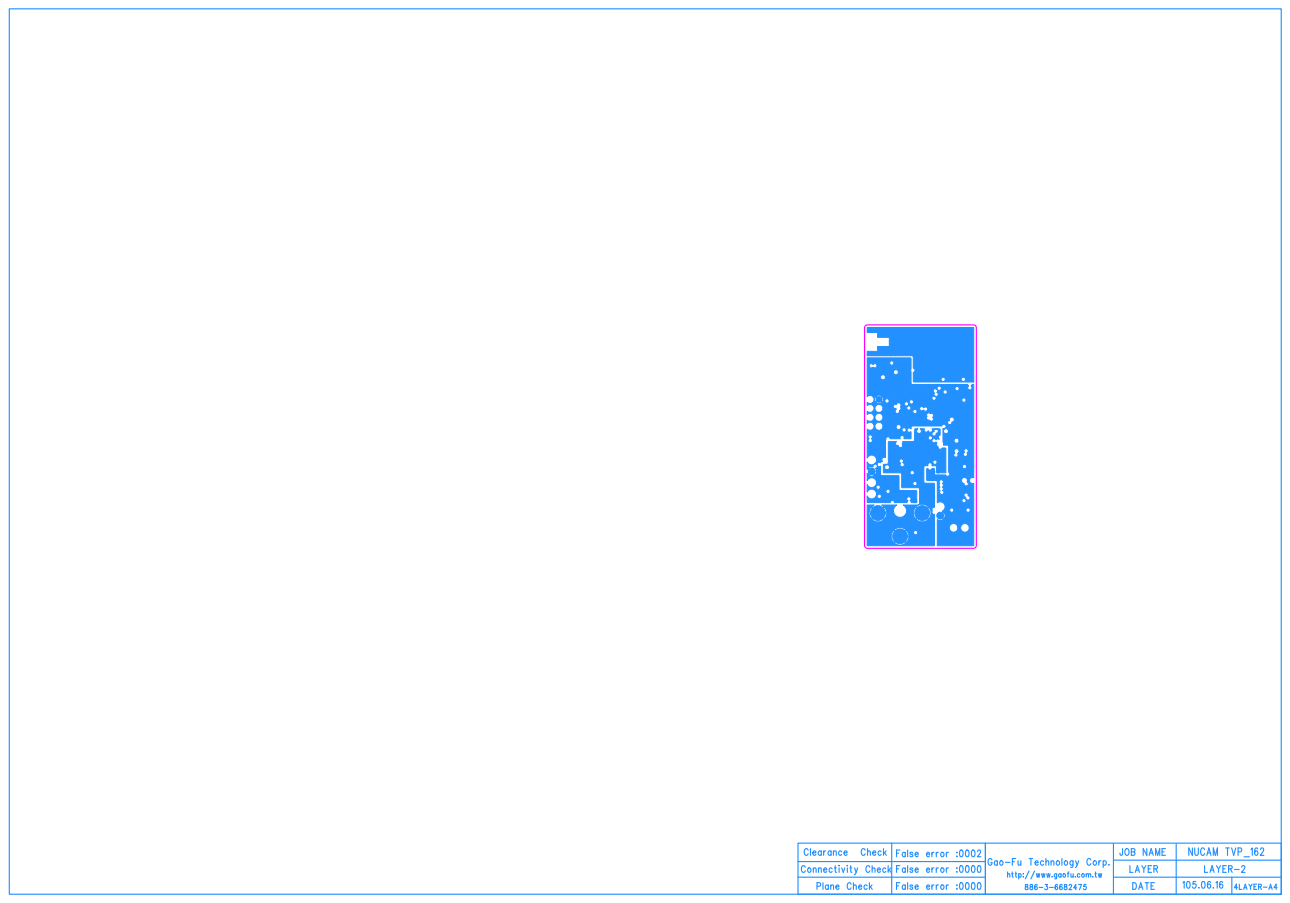
[picture p38: page 2]
CON1CON¹x1 CON¹x2 CON¹x3 CON¹x4; M1M¹x2; M¹x1; SW1 SW¹x6; SW¹x7; CON2 CON²x1 CON²x2 CON²x3 CON²x4 CON²x5 CON²x6 CON²x7 CON²x8

Clearance Check | False error :0002 | °ª¤Ò¬ì§Þ(ªÑ)¤½¥q Gao-Fu Technology Corp. http://www.gaofu.com.tw 886-3-6682475 | JOB NAME | NUCAM TVP_162
Connectivity Check | False error :0000 | | LAYER | LAYER-2
Plane Check | False error :0000 | | DATE | 105.06.16 | 4LAYER-A4

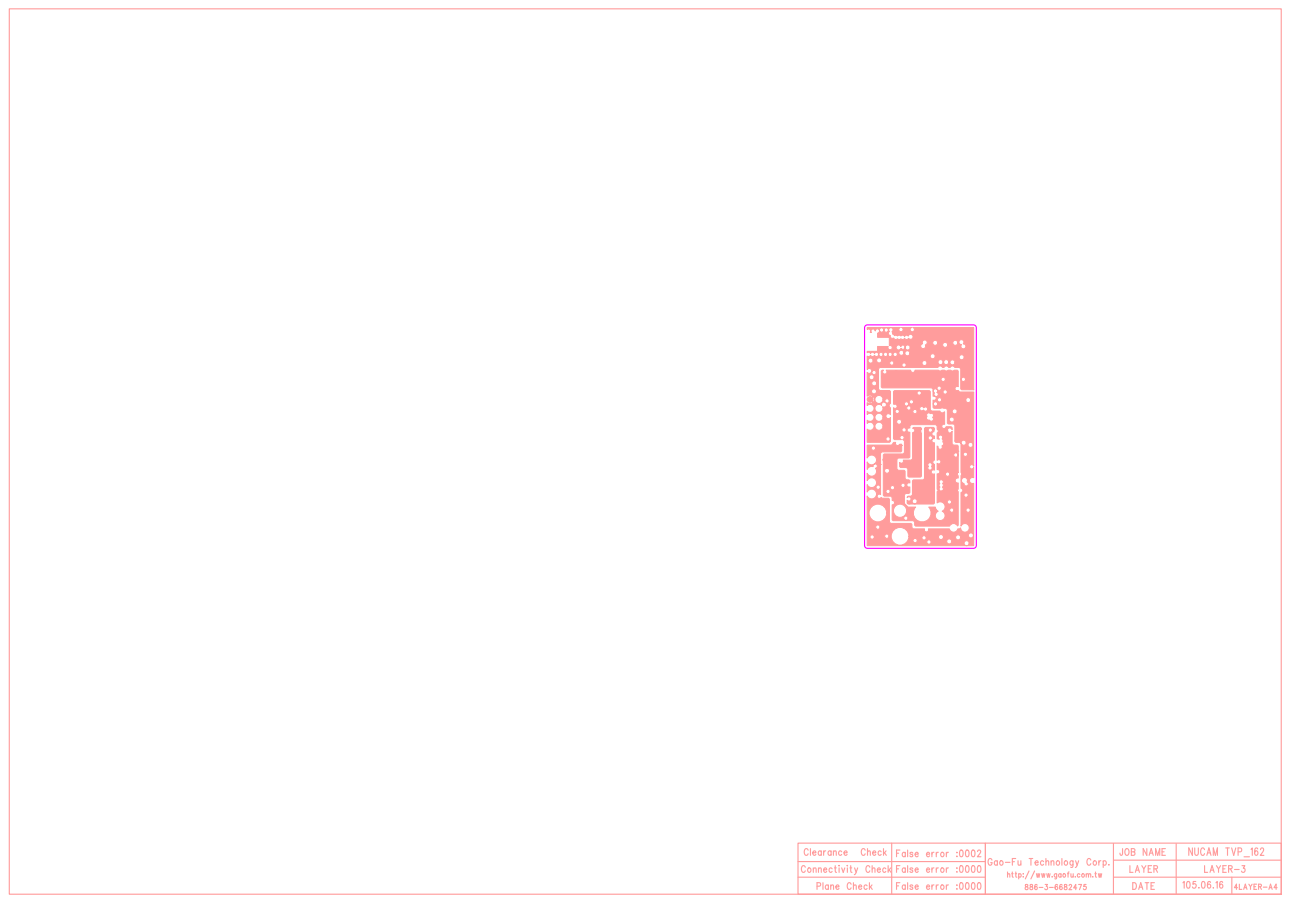
[picture p39: page 3]
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

Clearance Check | False error :0002 | °ª¤Ò¬ì§Þ(ªÑ)¤½¥q Gao-Fu Technology Corp. http://www.gaofu.com.tw 886-3-6682475 | JOB NAME | NUCAM TVP_162
Connectivity Check | False error :0000 | | LAYER | LAYER-3
Plane Check | False error :0000 | | DATE | 105.06.16 | 4LAYER-A4

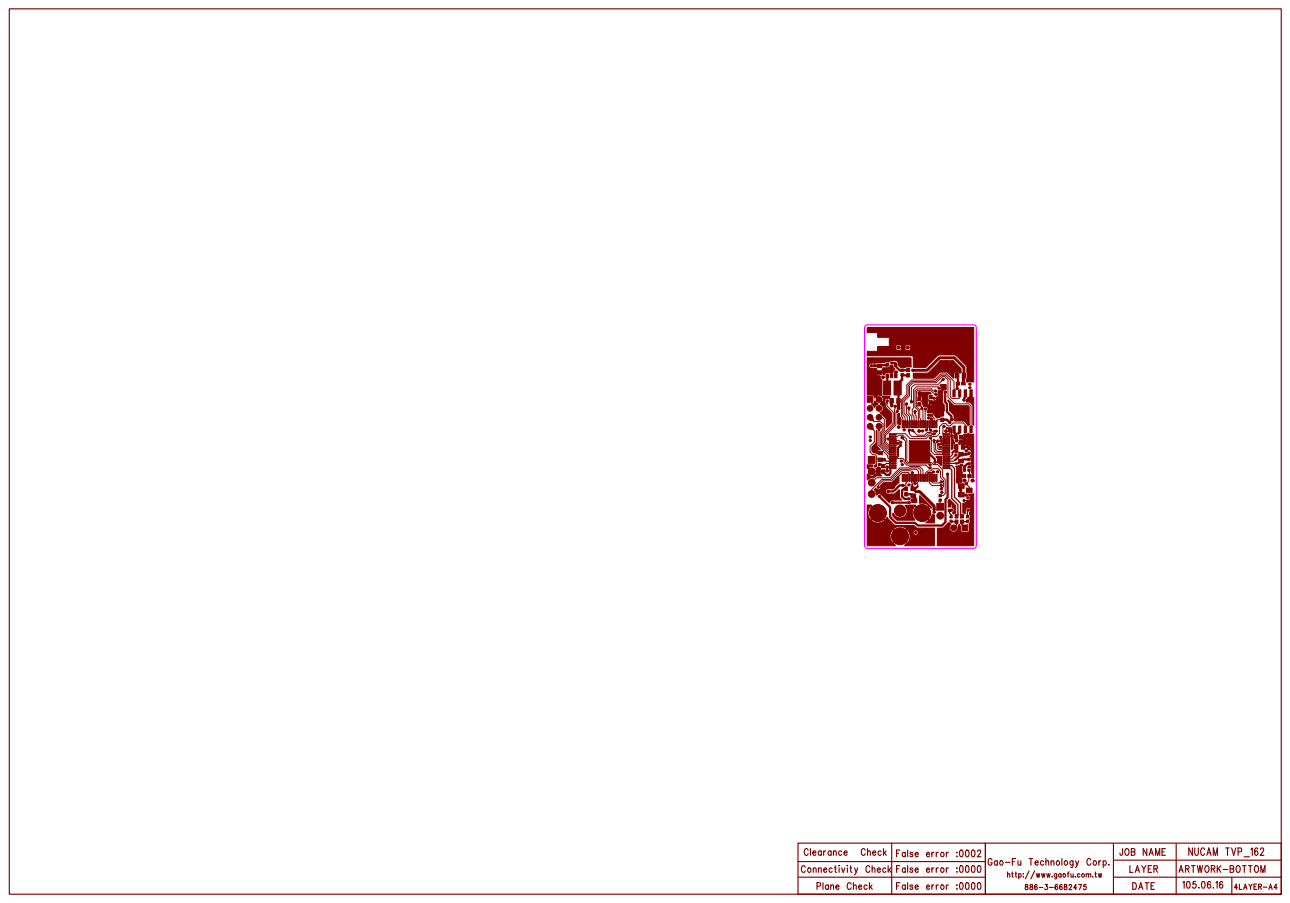
[picture p40: page 4]
U2U²x1 U²x2 U²x3 U²x4 U²x5 U²x6 U²x7 U²x8 U²x9 U²x10 U²x11 U²x12 U²x13 U²x14 U²x15 U²x16; U²x17 U²x18 U²x19 U²x20 U²x21 U²x22 U²x23 U²x24 U²x25 U²x26 U²x27 U²x28 U²x29 U²x30 U²x31 U²x32 U²x48 U²x47 U²x46 U²x45 U²x44 U²x43 U²x42 U²x41 U²x40 U²x39 U²x38 U²x37 U²x36 U²x35 U²x34 U²x33 U²x49 U²x50 U²x51 U²x52 U²x53 U²x54 U²x55 U²x56 U²x57 U²x58 U²x59 U²x60 U²x61 U²x62 U²x63 U²x64; U²x65; C5C⁵x1 C⁵x2; C6C⁶x1 C⁶x2; C7C⁷x2; C⁷x1; C8C⁸x1 C⁸x2; C9C⁹x1 C⁹x2; CB1CB¹x1 CB¹x2; CB2CB²x1 CB²x2; CB3 CB³x1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

Clearance Check | False error :0002 | °ª¤Ò¬ì§Þ(ªÑ)¤½¥q http://www.gaofu.com.tw 886-3-6682475 | JOB NAME | NUCAM TVP_162
Connectivity Check | False error :0000 | | LAYER | ARTWORK-BOTTOM Gao-Fu Technology Corp.
Plane Check | False error :0000 | | DATE | 105.06.16 | 4LAYER-A4

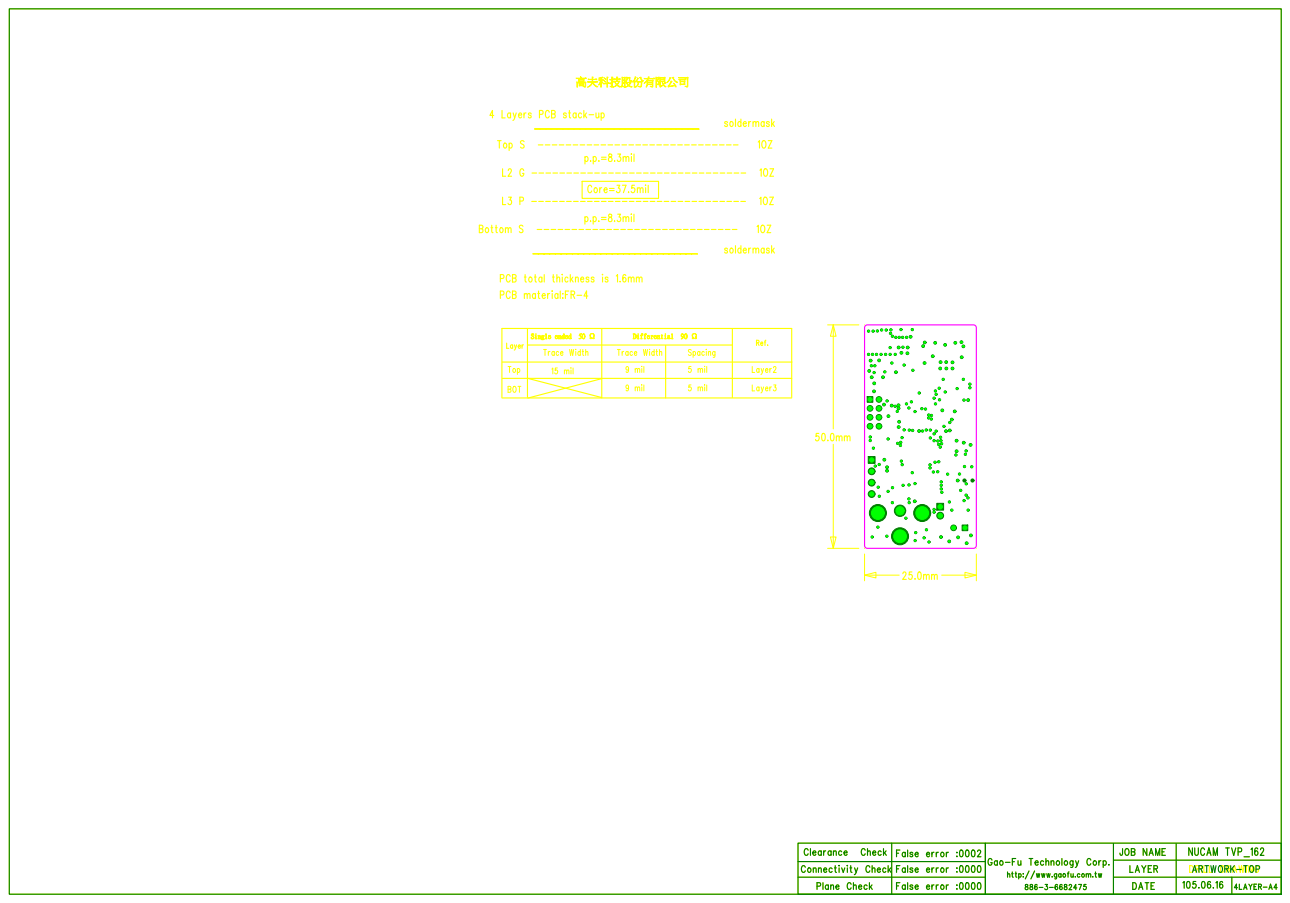
[picture p41: page 5]

4 Layers PCB stack-up

PCB total thickness is 1.6mm
PCB material:FR-4

Layer | Single ended 50 £[ | Differential 90 £[ | Ref.
Differential 90 £[ Trace Width | Trace Width | Spacing
Top | 15 mil | 9 mil | 5 mil | Layer2
BOT | | 9 mil | 5 mil | Layer3

Gao-Fu Technology Corp.

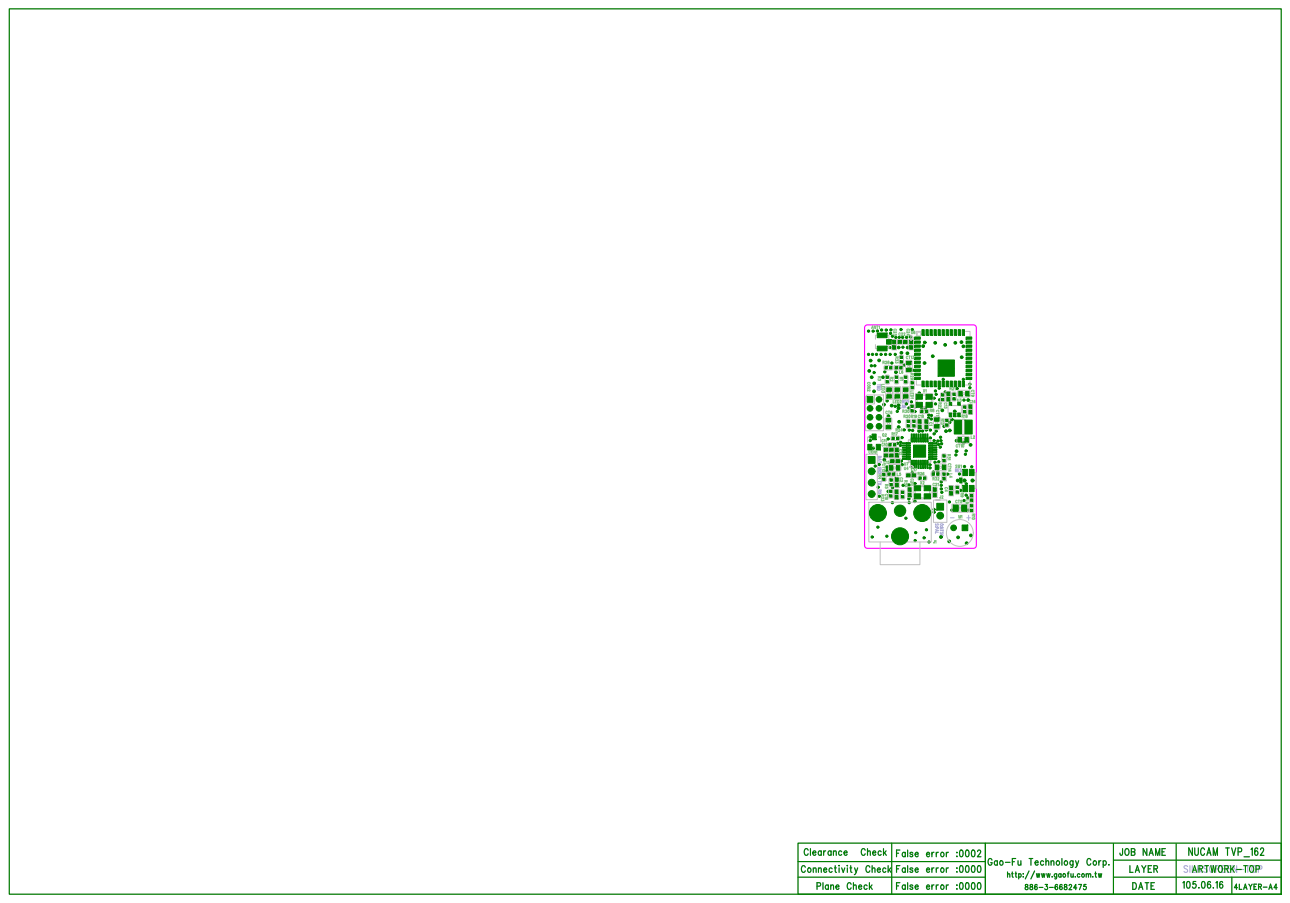
[picture p42: page 6]

Gao-Fu Technology Corp.

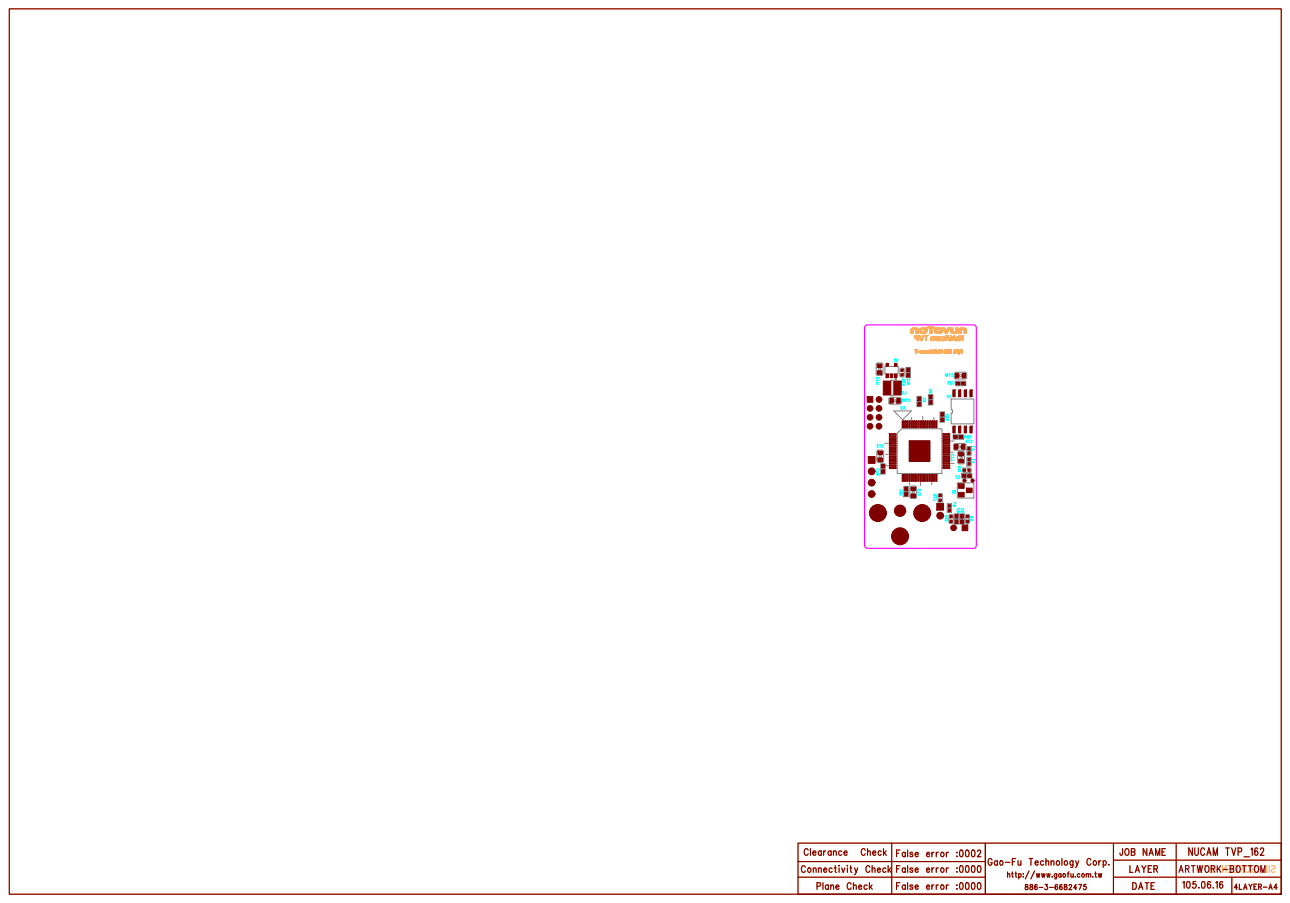
[picture p43: page 7]

Clearance Check | False error :0002 | °ª¤Ò¬ì§Þ(ªÑ)¤½¥q °ª¤Ò¬ì§Þ(ªÑ)¤½¥q Gao-Fu Technology Corp. http://www.gaofu.com.twhttp://www.gaofu.com.tw 886-3-6682475 886-3-6682475 | JOB NAME | NUCAM TVP_162
Connectivity Check | False error :0000 | | LAYER | ARTWORK-BOTTOM Gao-Fu Technology Corp. SILKSCREEN-BTM
Plane Check | False error :0000 | | DATE | 105.06.16 | 4LAYER-A4

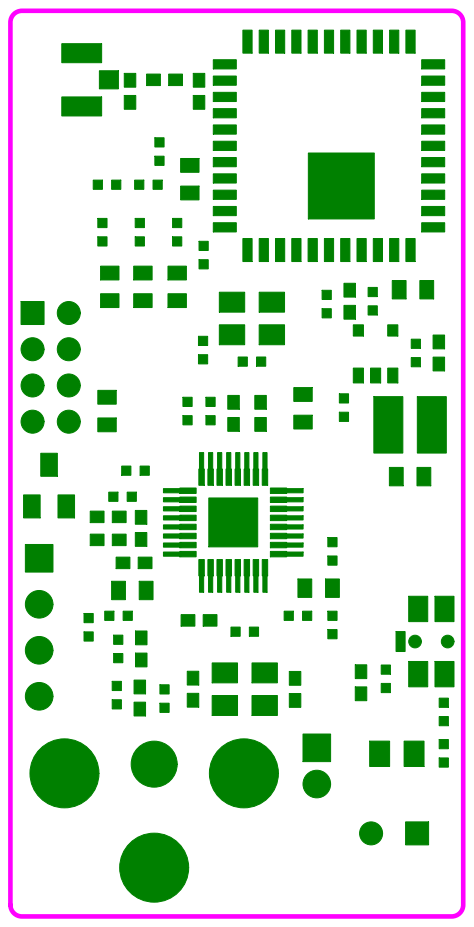
[picture p44: page 8]
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

C8C⁸x1 C⁸x2

C9C⁹x1 C⁹x2

CB1CB¹x1 CB¹x2

CB2CB²x1 CB²x2

CB3 CB³x1 CB³x2
CON1CON¹x1 CON¹x2 CON¹x3 CON¹x4
CT12 CT12x2 | CT12x1 | CT2CT2x1 CT2x2

CT3CT3x1 CT3x2

CT4 CT4x1 CT4x2

CT8CT8x1 CT8x2

L1L1x1 L1x2

L3L3x1 | L3x2
M1M¹x2 | M¹x1 Q1Q¹xBQ¹xCQ¹xE R11R¹¹x1 R¹¹x2
R12 R¹²x1 | R¹²x2
R15R¹⁵x1 R¹⁵x2 U1U¹x1 | U¹x2 | U¹x3 | U¹x4 U¹x8 | U¹x7 | U¹x6 | U¹x5
U5U⁵x3 | U⁵x2 | U⁵x1 U⁵x4 | U⁵x5

J2J2x1 J2x2

C19C¹⁹x1 C¹⁹x2

C25C²⁵x2 | C²⁵x1

CT11CT11x1 CT11x2
R25R²⁵x1 R²⁵x2

R27R²⁷x1 R²⁷x2
J1J1x1 J1x2 J1x4 | J1x3
SW1 SW¹x6 | SW¹x7

CT7CT7x1 CT7x2

## CT16 CT16x2 CT16x1 L7L7x1 L7x2

L8L8x1 L8x2

## CON2 CON²x1 CON²x2 CON²x3 CON²x4 CON²x5 CON²x6 CON²x7 CON²x8

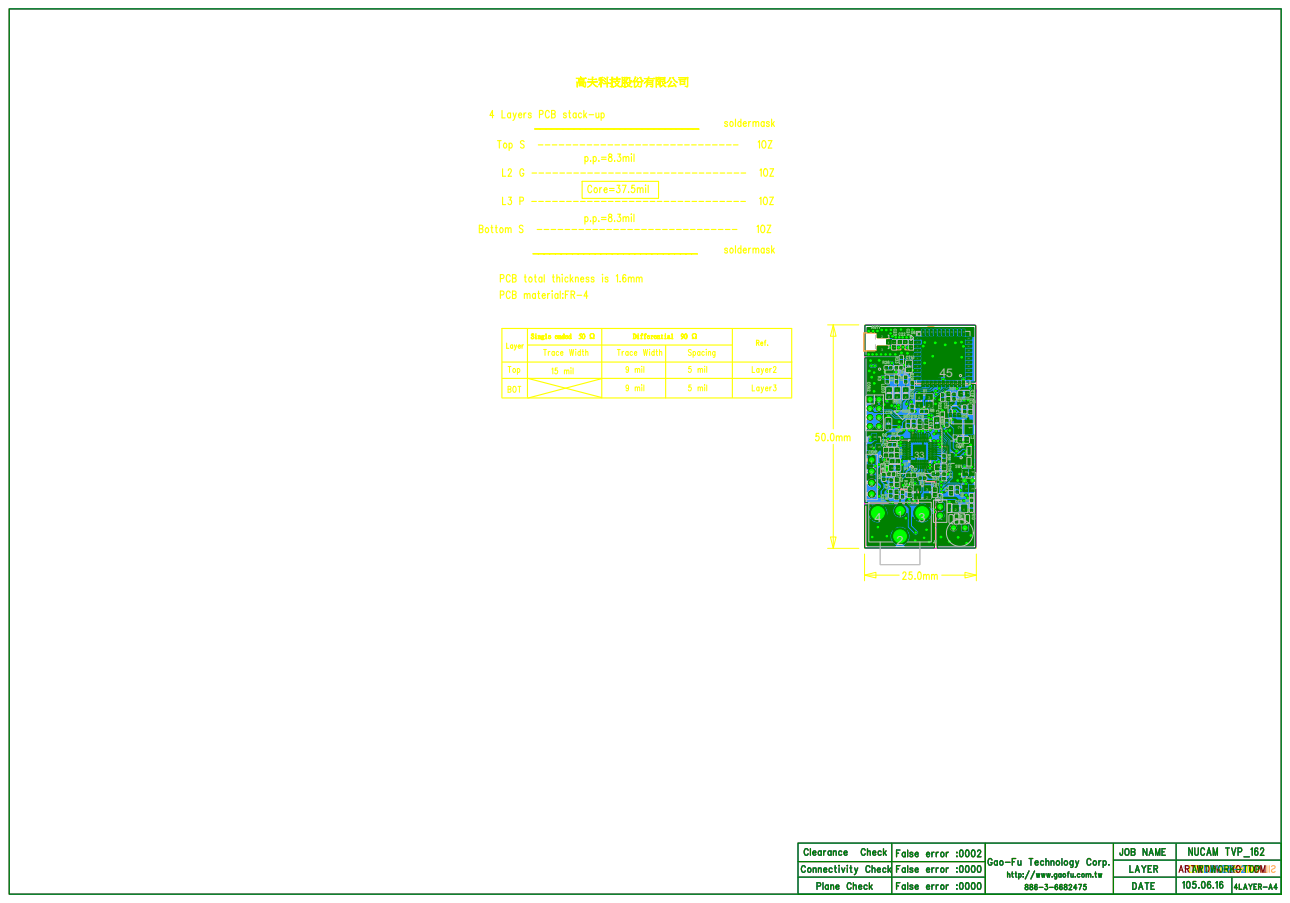
[picture p45: page 10]

4 Layers PCB stack-up

PCB total thickness is 1.6mm
PCB material:FR-4

Clearance Check Clearance Check Clearance Check Clearance Check Clearance Check Clearance Check Clearance Check | False error :0002 False error :0002 False error :0002 False error :0002 False error :0002 False error :0002 False error :0002 | °ª¤Ò¬ì§Þ(ªÑ)¤½¥q °ª¤Ò¬ì§Þ(ªÑ)¤½¥q °ª¤Ò¬ì§Þ(ªÑ)¤½¥q °ª¤Ò¬ì§Þ(ªÑ)¤½¥q °ª¤Ò¬ì§Þ(ªÑ)¤½¥q °ª¤Ò¬ì§Þ(ªÑ)¤½¥q °ª¤Ò¬ì§Þ(ªÑ)¤½¥q Gao-Fu Technology Corp. Gao-Fu Technology Corp. Gao-Fu Technology Corp. Gao-Fu Technology Corp. Gao-Fu Technology Corp. Gao-Fu Technology Corp. http://www.gaofu.com.twhttp://www.gaofu.com.twhttp://www.gaofu.com.twhttp://www.gaofu.com.twhttp://www.gaofu.com.twhttp://www.gaofu.com.twhttp://www.gaofu.com.tw 886-3-6682475 886-3-6682475 886-3-6682475 886-3-6682475 886-3-6682475 886-3-6682475 886-3-6682475 | JOB NAME JOB NAME JOB NAME JOB NAME JOB NAME JOB NAME JOB NAME | NUCAM TVP_162 NUCAM TVP_162 NUCAM TVP_162 NUCAM TVP_162 NUCAM TVP_162 NUCAM TVP_162 NUCAM TVP_162
Connectivity Check Connectivity Check Connectivity Check Connectivity Check Connectivity Check Connectivity Check Connectivity Check | False error :0000 False error :0000 False error :0000 False error :0000 False error :0000 False error :0000 False error :0000 | | LAYER LAYER LAYER LAYER LAYER LAYER LAYER | ARTWORK-BOTTOM Gao-Fu Technology Corp. SILKSCREEN-TOP DRILL DRAWING ARTWORK-TOP LAYER-3 LAYER-2 SILKSCREEN-BTM
Plane Check Plane Check Plane Check Plane Check Plane Check Plane Check Plane Check | False error :0000 False error :0000 False error :0000 False error :0000 False error :0000 False error :0000 False error :0000 | | DATE DATE DATE DATE DATE DATE DATE | 105.06.16 105.06.16 105.06.16 105.06.16 105.06.16 105.06.16 105.06.16 | 4LAYER-A4 4LAYER-A4 4LAYER-A4 4LAYER-A4 4LAYER-A4 4LAYER-A4 4LAYER-A4
