OpenNuvoton/NuMaker_NuWicam_RDK/hardware_design/PCB/NUCAM VGA_162.pdf

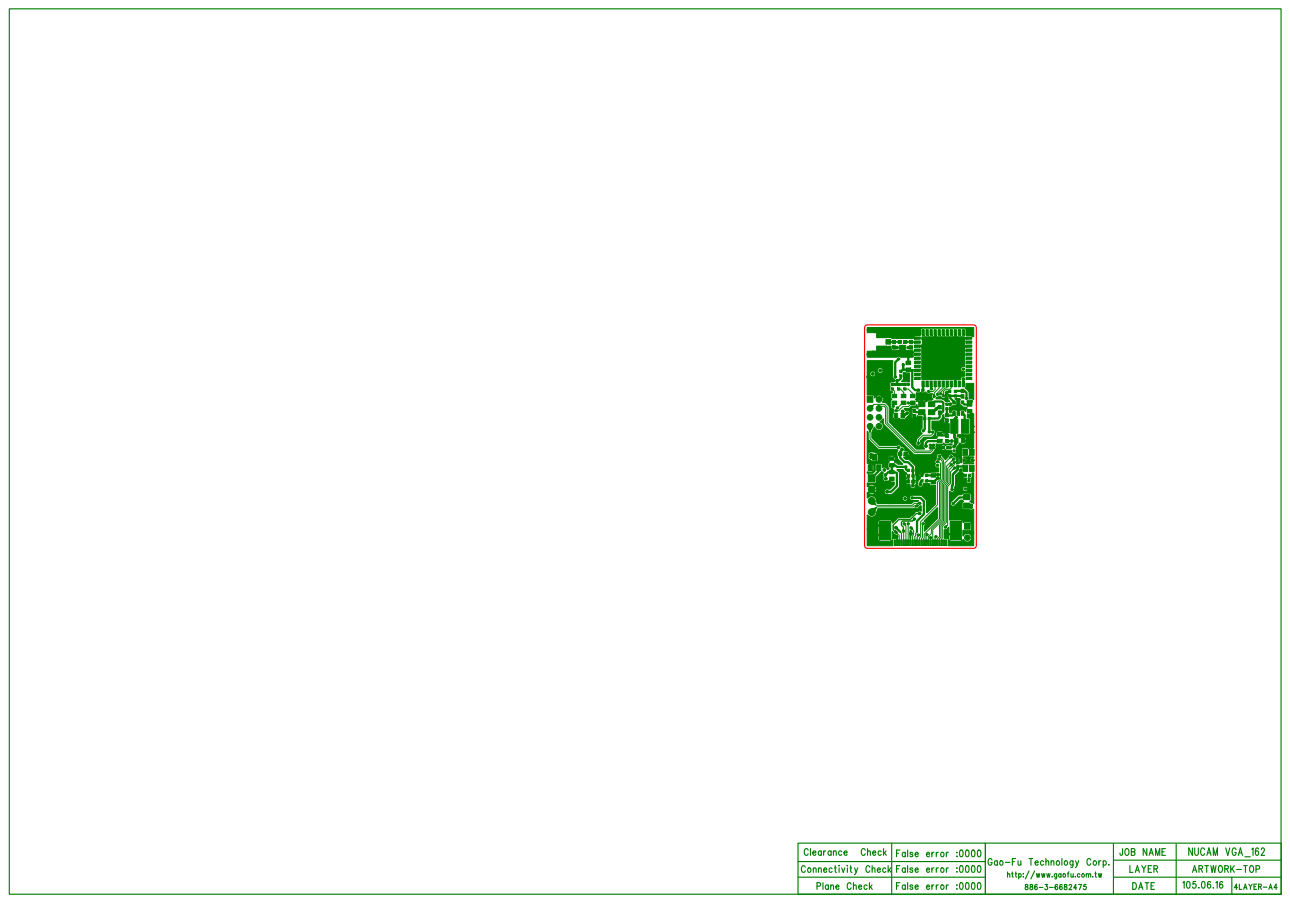
[picture p46: page 1]
http://www.gaofu.com.tw; ARTWORK-TOP; DATE; LAYER; JOB NAME; False error :0000; 4LAYER-A4; Connectivity Check; Clearance Check; Plane Check; NUCAM VGA_162; C1C¹x1; C¹x2; C10C¹⁰x1 C¹⁰x2; C11C¹¹x1 C¹¹x2; C13C¹³x1; C¹³x2; C14C¹⁴x1 C¹⁴x2; C15C¹⁵x1 C¹⁵x2; C2C²x2; C²x1 C5C⁵x1 C⁵x2; C6C⁶x1 C⁶x2; CB2CB²x1 CB²x2; CON1CON¹x1 CON¹x2 CON¹x3 CON¹x4; LED1LED¹x1; LED2; LED1x2; LED2x1; LED3; LED2x2; LED3x1 LED3x2; M1M¹x1 M¹x2; R1R¹x1 R¹x2; R13 R¹³x1; R¹³x2 R17R¹⁷x1 R¹⁷x2; R18R¹⁸x1 R¹⁸x2; R19R¹⁹x1 R¹⁹x2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

Gao-Fu Technology Corp.

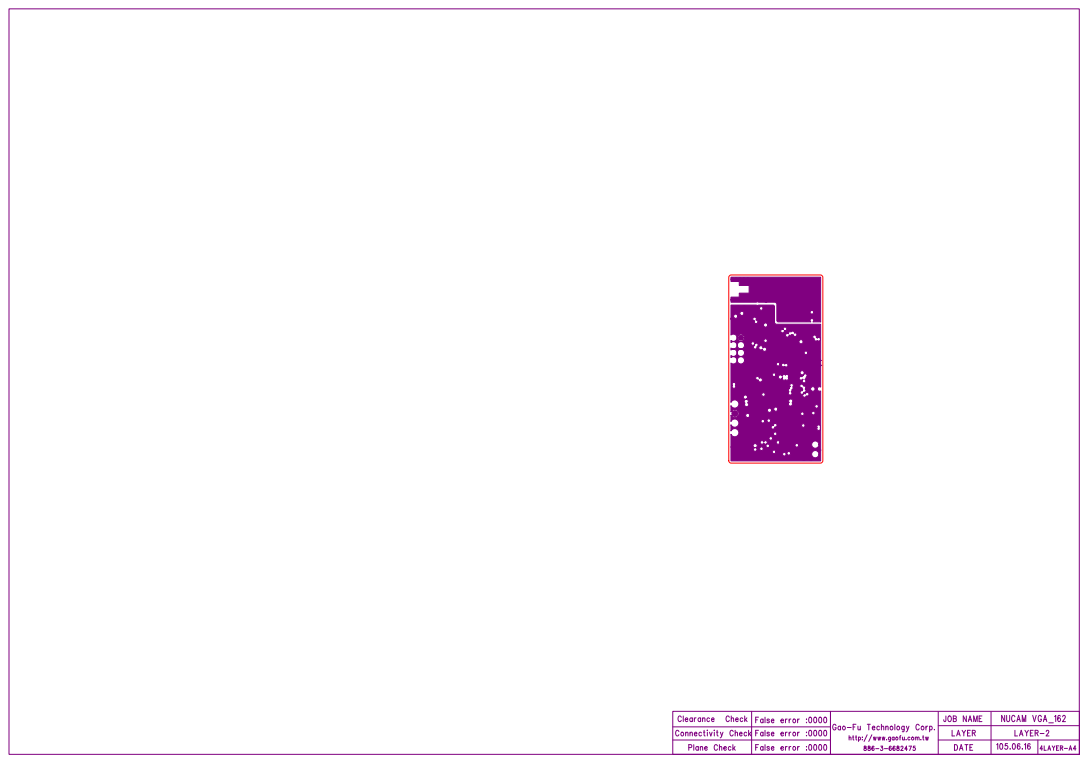
[picture p47: page 2]
CON1CON¹x1 CON¹x2 CON¹x3 CON¹x4; M1M¹x1 M¹x2 SW1 SW¹x6; SW¹x7; CON2 CON²x1 CON²x2 CON²x3 CON²x4 CON²x5 CON²x6 CON²x7 CON²x8

Clearance Check | False error :0000 | °ª¤Ò¬ì§Þ(ªÑ)¤½¥q Gao-Fu Technology Corp. http://www.gaofu.com.tw 886-3-6682475 | JOB NAME | NUCAM VGA_162
Connectivity Check | False error :0000 | | LAYER | LAYER-2
Plane Check | False error :0000 | | DATE | 105.06.16 | 4LAYER-A4

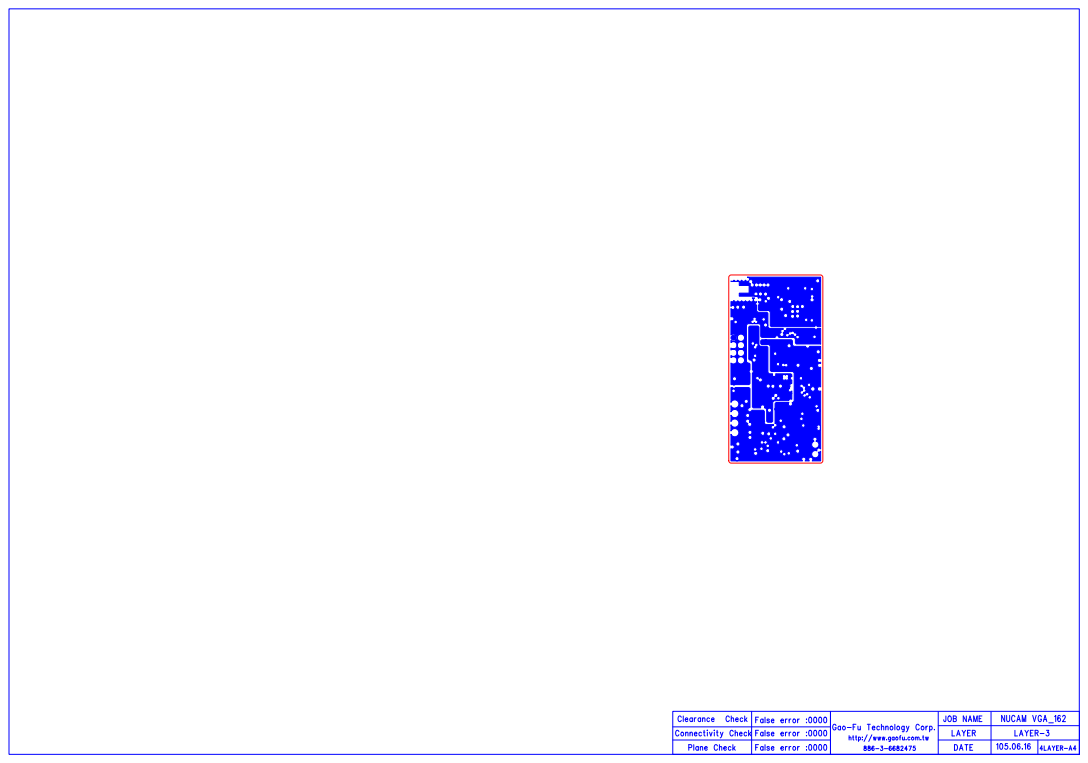
[picture p48: page 3]
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

Clearance Check | False error :0000 | °ª¤Ò¬ì§Þ(ªÑ)¤½¥q Gao-Fu Technology Corp. http://www.gaofu.com.tw 886-3-6682475 | JOB NAME | NUCAM VGA_162
Connectivity Check | False error :0000 | | LAYER | LAYER-3
Plane Check | False error :0000 | | DATE | 105.06.16 | 4LAYER-A4

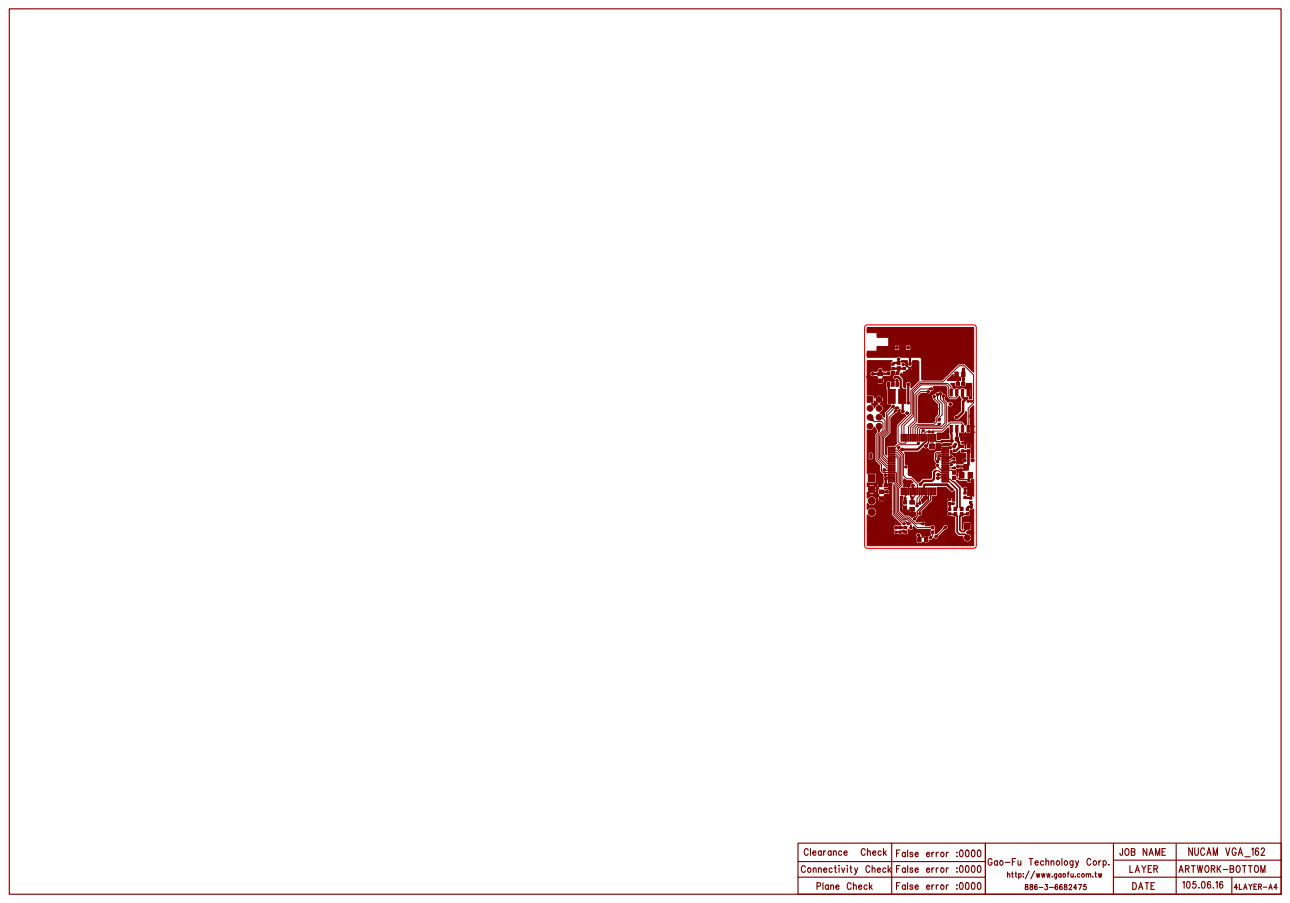
[picture p49: page 4]
U2U²x1 U²x2 U²x3 U²x4 U²x5 U²x6 U²x7 U²x8 U²x9 U²x10 U²x11 U²x12 U²x13 U²x14 U²x15 U²x16; U²x17 U²x18 U²x19 U²x20 U²x21 U²x22 U²x23 U²x24 U²x25 U²x26 U²x27 U²x28 U²x29 U²x30 U²x31 U²x32 U²x48 U²x47 U²x46 U²x45 U²x44 U²x43 U²x42 U²x41 U²x40 U²x39 U²x38 U²x37 U²x36 U²x35 U²x34 U²x33 U²x49 U²x50 U²x51 U²x52 U²x53 U²x54 U²x55 U²x56 U²x57 U²x58 U²x59 U²x60 U²x61 U²x62 U²x63 U²x64; U²x65; C12C¹²x1 C¹²x2; C4C⁴x1 C⁴x2; C7C⁷x1 C⁷x2; C8C⁸x1 C⁸x2; C9C⁹x1; CB3 CB³x1; CB³x2; CB4 CB⁴x2; CB⁴x1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

Clearance Check | False error :0000 | °ª¤Ò¬ì§Þ(ªÑ)¤½¥q http://www.gaofu.com.tw 886-3-6682475 | JOB NAME | NUCAM VGA_162
Connectivity Check | False error :0000 | | LAYER | ARTWORK-BOTTOM Gao-Fu Technology Corp.
Plane Check | False error :0000 | | DATE | 105.06.16 | 4LAYER-A4

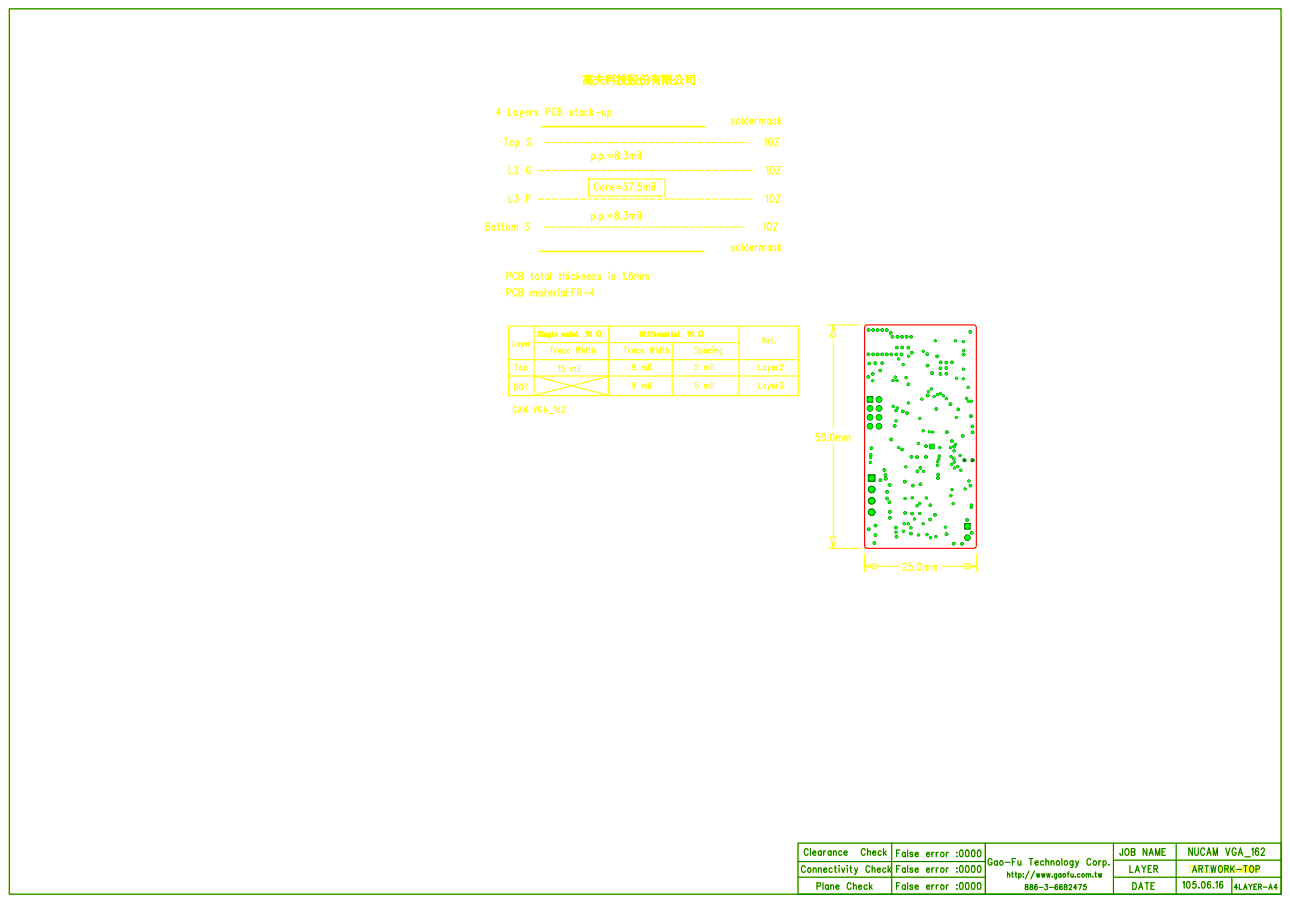
[picture p50: page 5]

4 Layers PCB stack-up

PCB total thickness is 1.6mm
PCB material:FR-4

Layer | Single ended 50 £[ | Differential 90 £[ | Ref.
Differential 90 £[ Trace Width | Trace Width | Spacing
Top | 15 mil | 9 mil | 5 mil | Layer2
BOT | | 9 mil | 5 mil | Layer3

Gao-Fu Technology Corp.

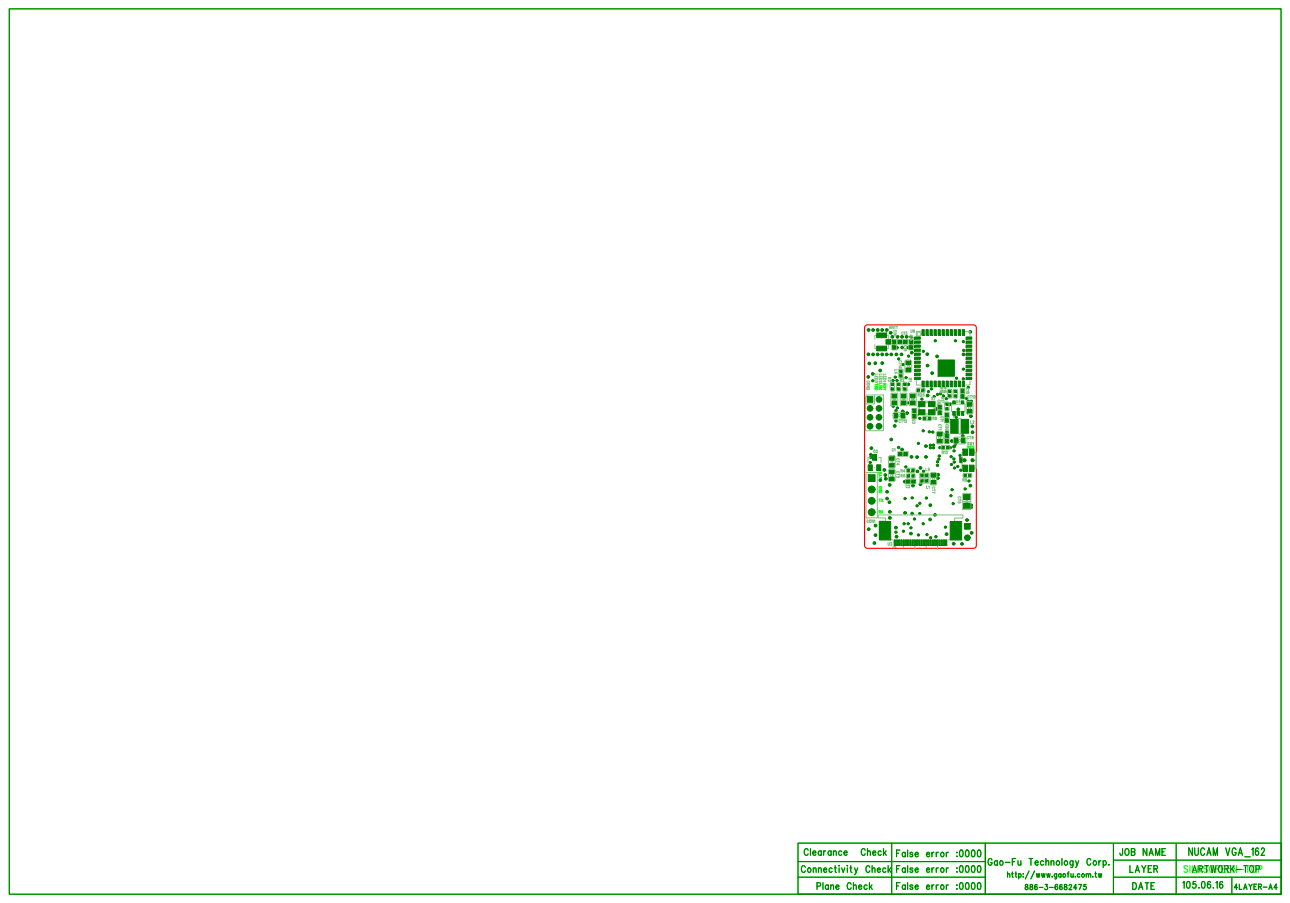
[picture p51: page 6]

Gao-Fu Technology Corp.

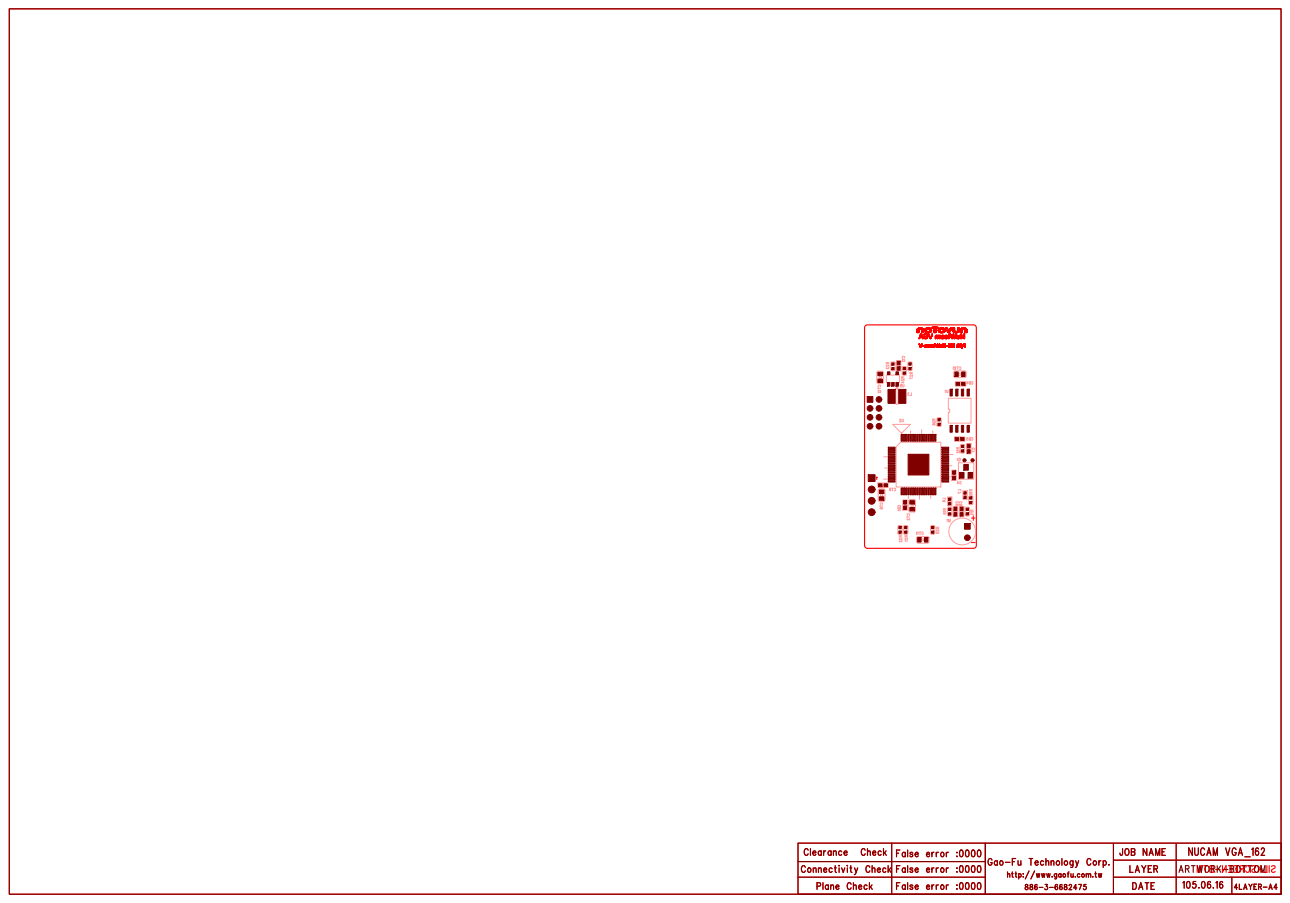
[picture p52: page 7]

Clearance Check | False error :0000 | °ª¤Ò¬ì§Þ(ªÑ)¤½¥q °ª¤Ò¬ì§Þ(ªÑ)¤½¥q Gao-Fu Technology Corp. http://www.gaofu.com.twhttp://www.gaofu.com.tw 886-3-6682475 886-3-6682475 | JOB NAME | NUCAM VGA_162
Connectivity Check | False error :0000 | | LAYER | ARTWORK-BOTTOM Gao-Fu Technology Corp. SILKSCREEN-BTM
Plane Check | False error :0000 | | DATE | 105.06.16 | 4LAYER-A4

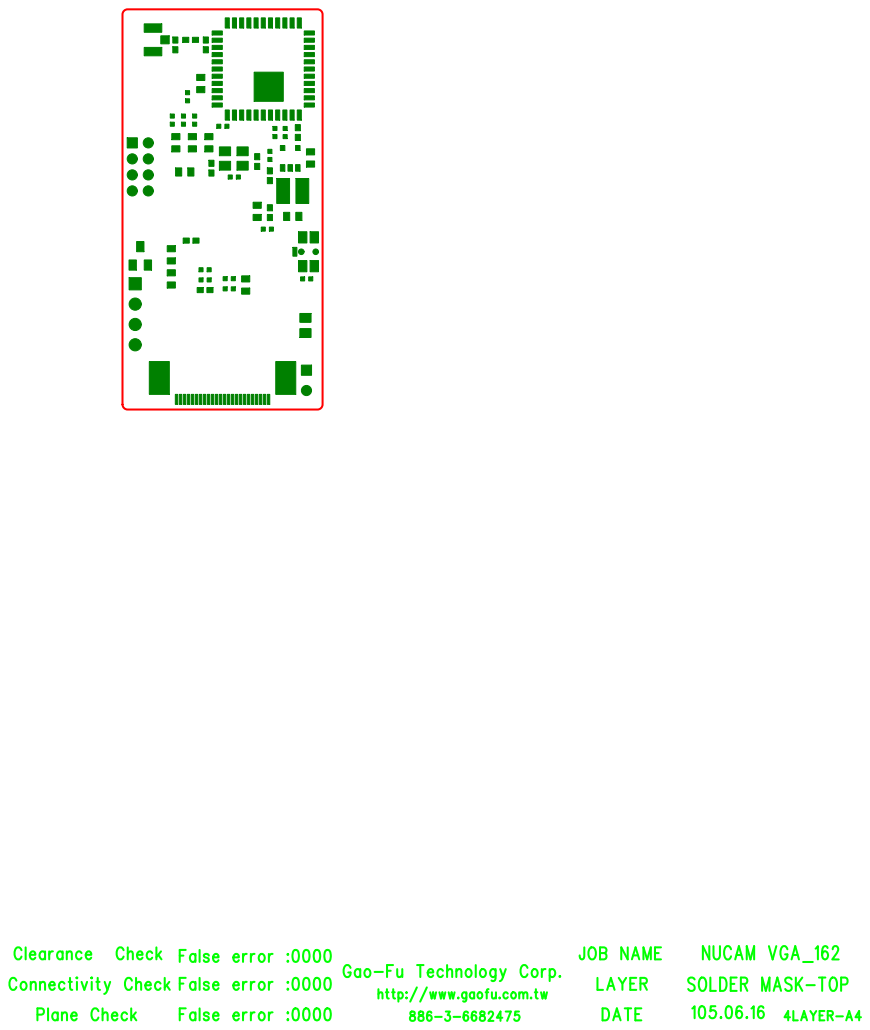
[picture p53: page 8]
DATE; LAYER; JOB NAME; False error :0000; 4LAYER-A4; Connectivity Check; Clearance Check; Plane Check; SOLDER MASK-TOP; NUCAM VGA_162; C1C¹x1; C¹x2; C10C¹⁰x1 C¹⁰x2; C11C¹¹x1 C¹¹x2; C13C¹³x1; C¹³x2; C14C¹⁴x1 C¹⁴x2; C15C¹⁵x1 C¹⁵x2; C2C²x2; C²x1 C5C⁵x1 C⁵x2; C6C⁶x1 C⁶x2; CB2CB²x1 CB²x2; CON1CON¹x1 CON¹x2 CON¹x3 CON¹x4; LED1LED¹x1; LED2; LED1x2; LED2x1; LED3; LED2x2; LED3x1 LED3x2; M1M¹x1 M¹x2; R1R¹x1 R¹x2; R13 R¹³x1; R¹³x2 R17R¹⁷x1 R¹⁷x2; R18R¹⁸x1 R¹⁸x2; R19R¹⁹x1 R¹⁹x2; R2R²x1; R25 R²⁵x1; R²⁵x2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

Gao-Fu Technology Corp.
http://www.gaofu.com.tw

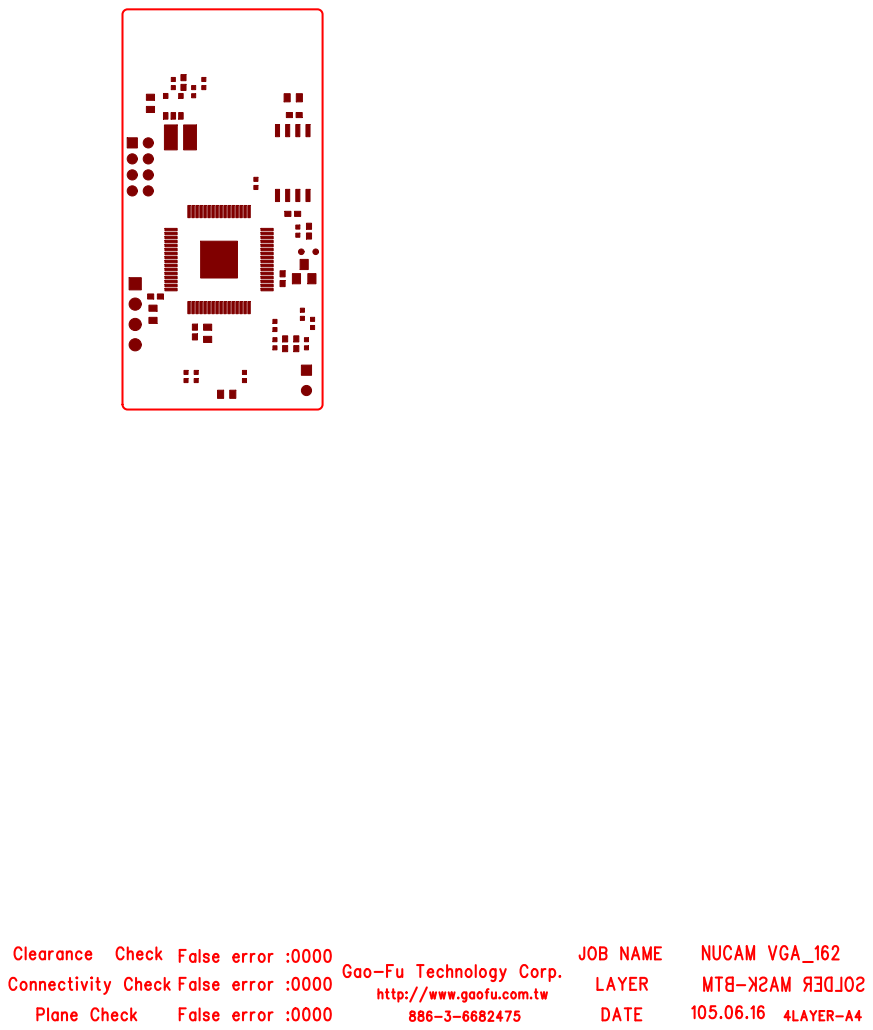
[picture p54: page 9]
DATE; LAYER; JOB NAME; False error :0000; 4LAYER-A4; Connectivity Check; Clearance Check; Plane Check; NUCAM VGA_162; U2U²x1 U²x2 U²x3 U²x4 U²x5 U²x6 U²x7 U²x8 U²x9 U²x10 U²x11 U²x12 U²x13 U²x14 U²x15 U²x16; U²x17 U²x18 U²x19 U²x20 U²x21 U²x22 U²x23 U²x24 U²x25 U²x26 U²x27 U²x28 U²x29 U²x30 U²x31 U²x32 U²x48 U²x47 U²x46 U²x45 U²x44 U²x43 U²x42 U²x41 U²x40 U²x39 U²x38 U²x37 U²x36 U²x35 U²x34 U²x33 U²x49 U²x50 U²x51 U²x52 U²x53 U²x54 U²x55 U²x56 U²x57 U²x58 U²x59 U²x60 U²x61 U²x62 U²x63 U²x64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

Gao-Fu Technology Corp.
http://www.gaofu.com.tw

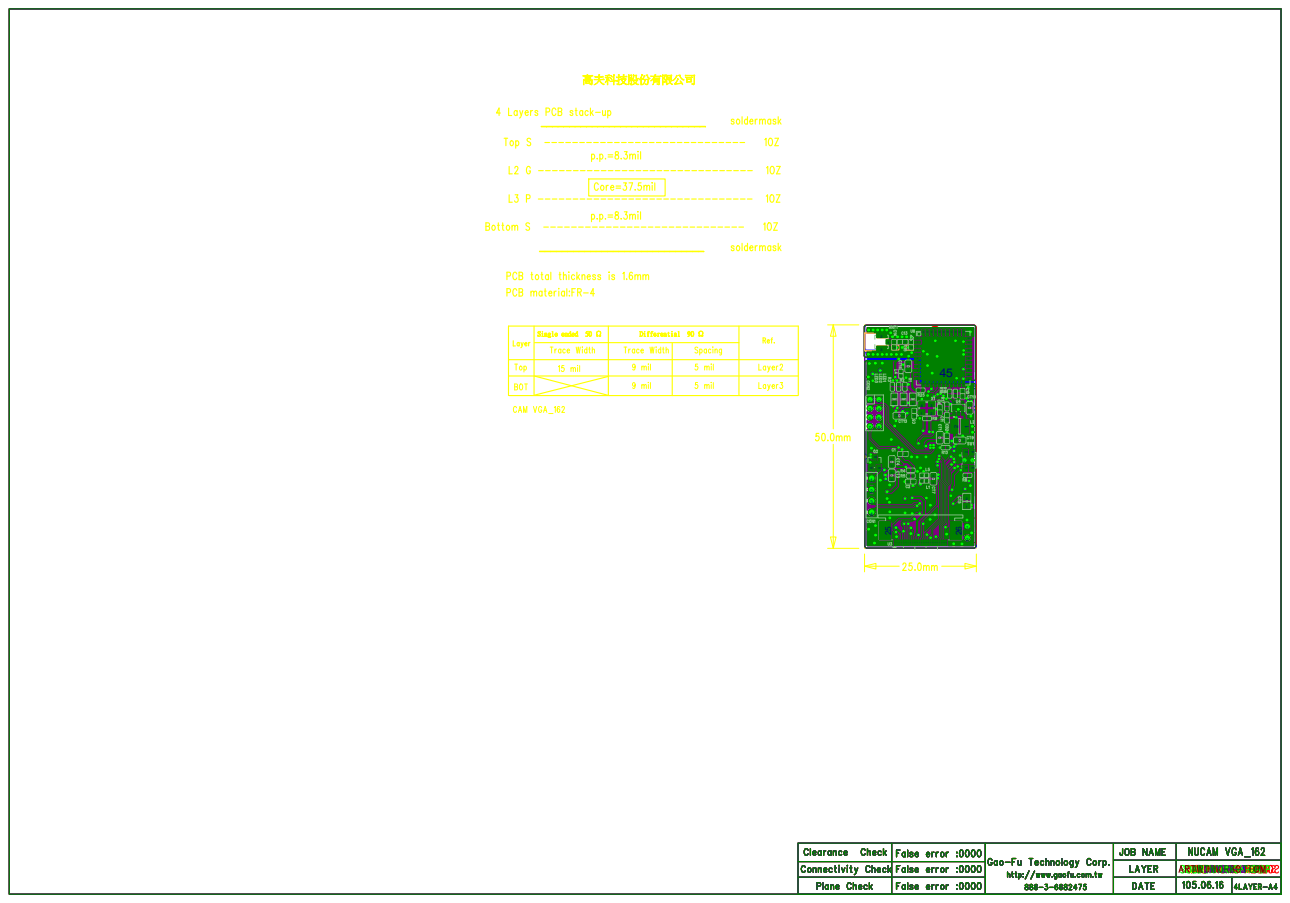
[picture p55: page 10]

4 Layers PCB stack-up

PCB total thickness is 1.6mm
PCB material:FR-4

Gao-Fu Technology Corp.
http://www.gaofu.com.tw

ARTWORK-BOTTOM Gao-Fu Technology Corp.

SOLDER MASK-TOP
SMD Paste Mask-BTM
SMD Paste Mask-TOP
