OpenNuvoton/NuMaker_NuWicam_RDK/hardware_design/SCH/nuwicam vga 20160607.pdf

## STATUS INDICATOR

## 3.5V~6V, BAT/DC-5V INPUT

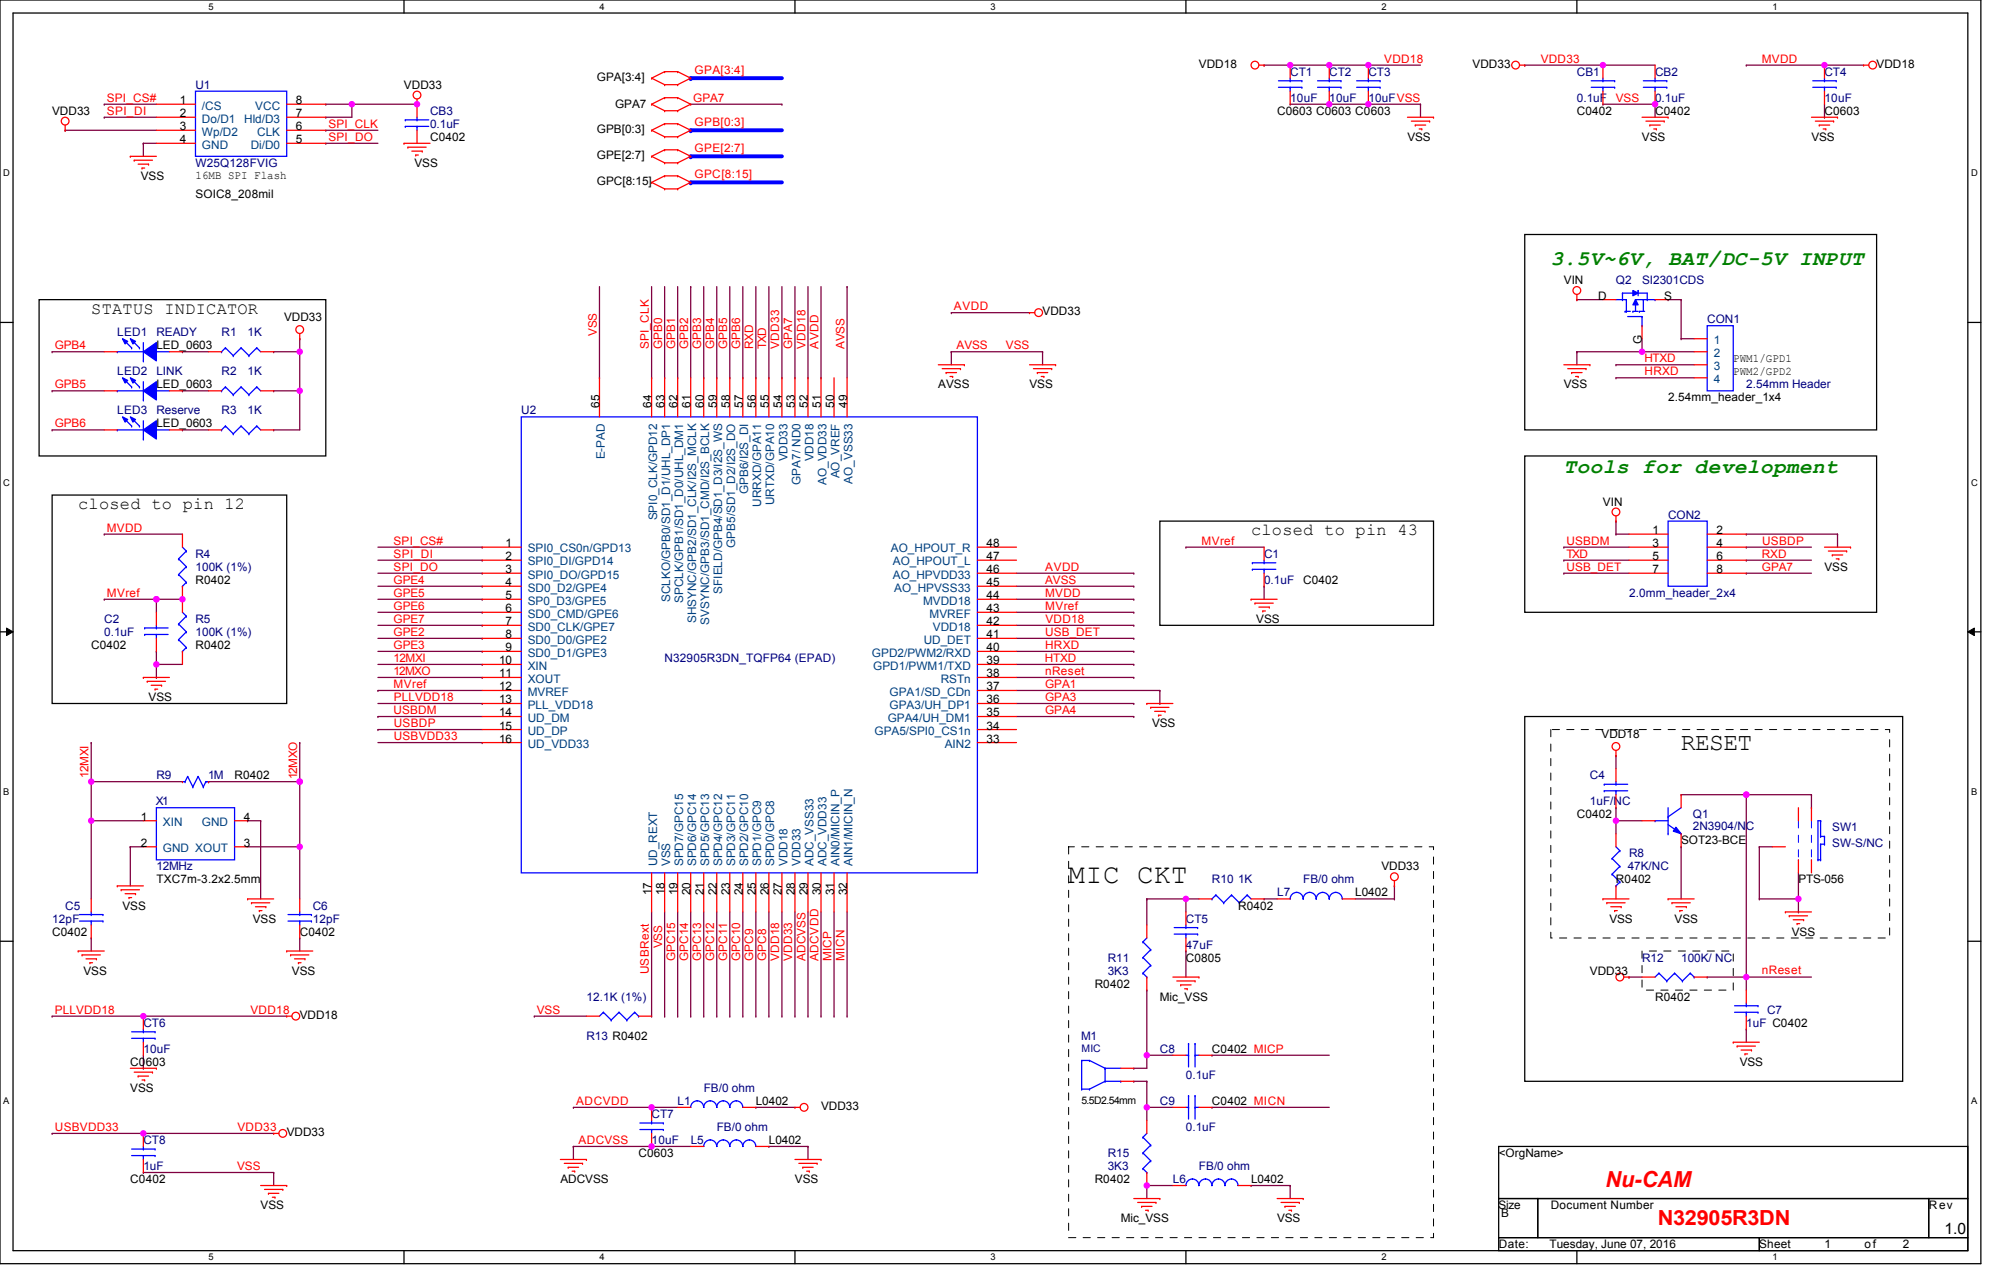
[picture p58: page 1]

Power Supply with DC-DC | VGA CMOS Sensor with GC0308

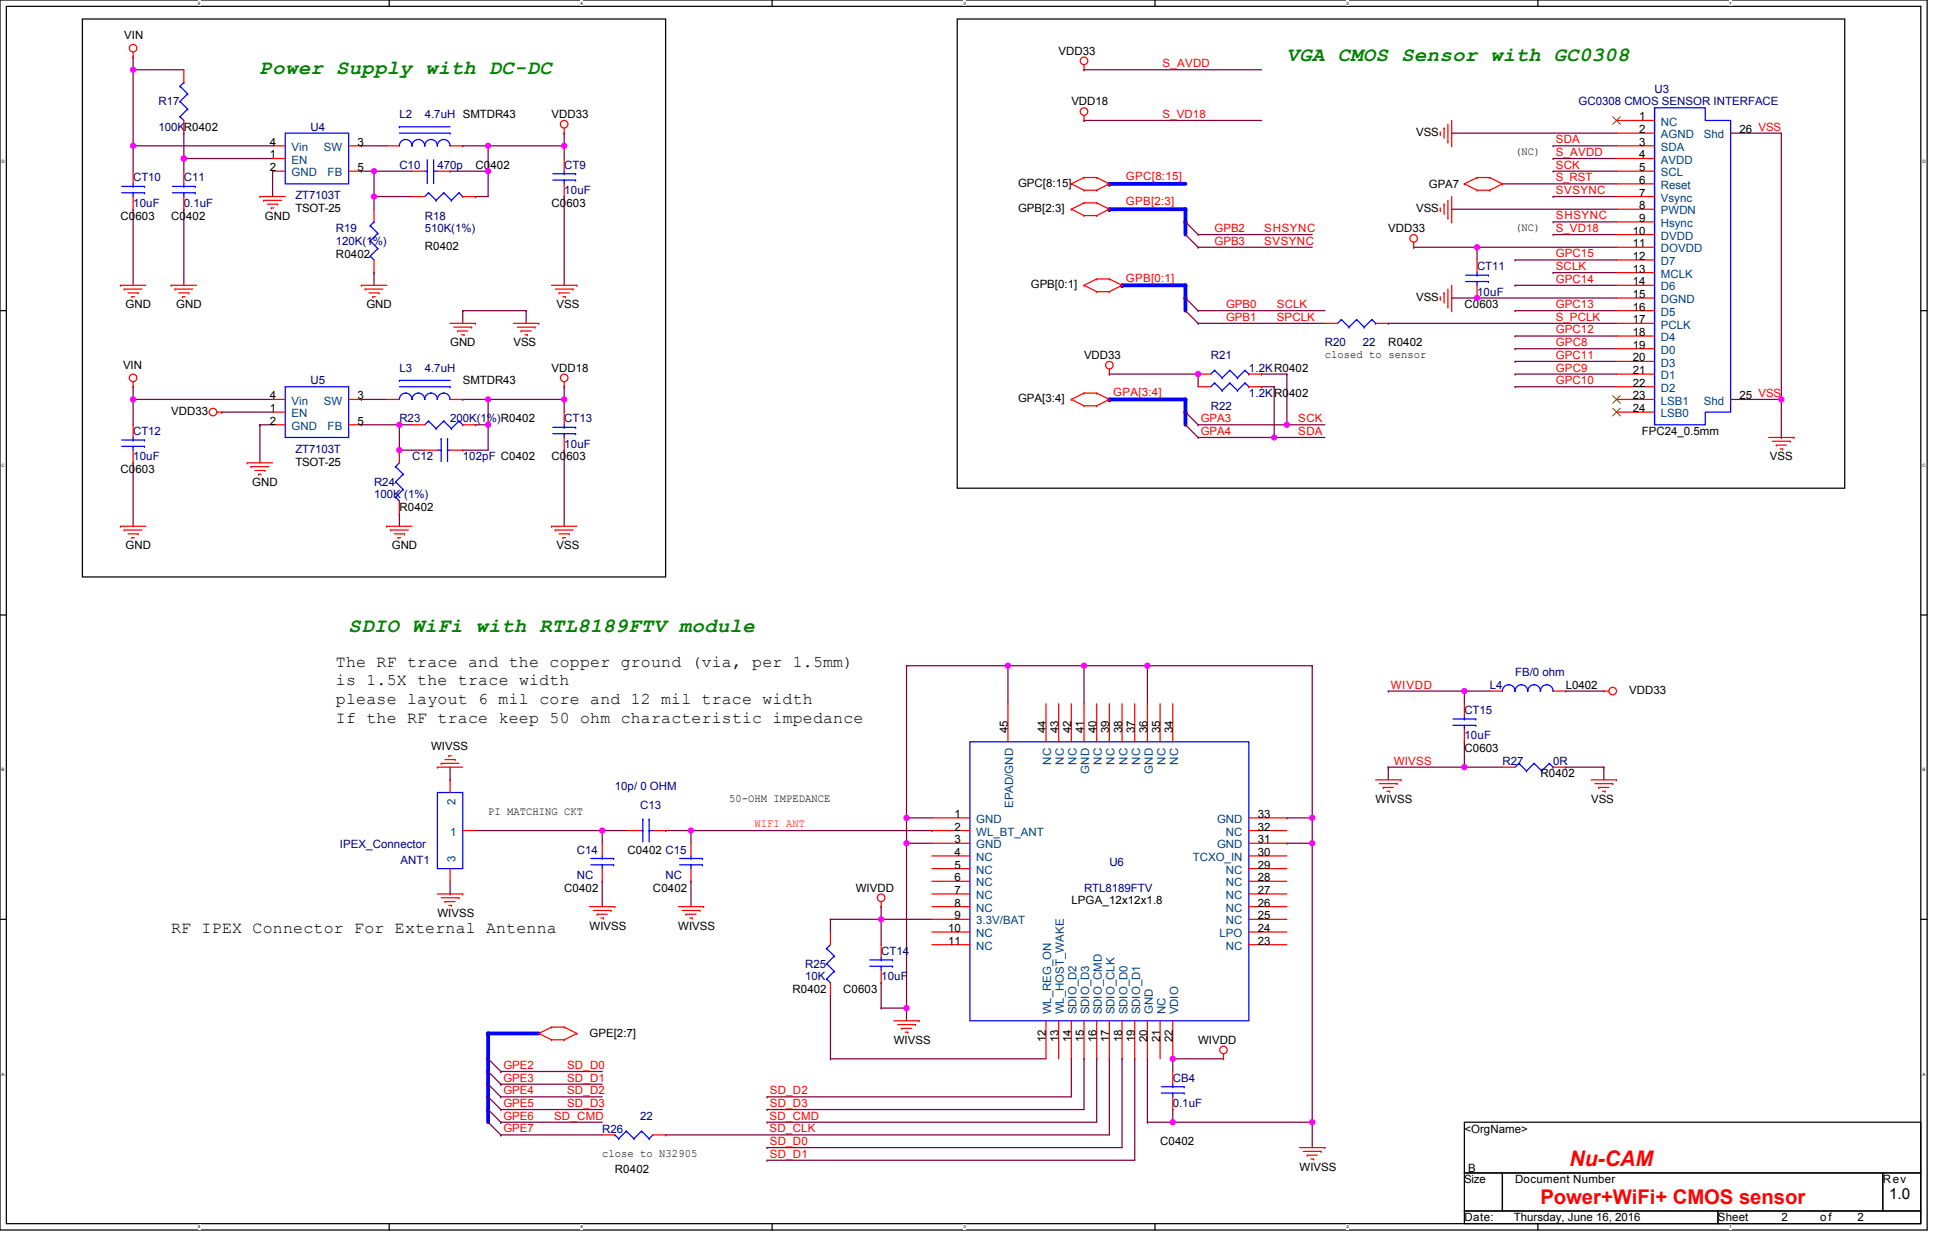
[picture p59: page 2]

SDIO WiFi with RTL8189FTV module

The RF trace and the copper ground (via, per 1.5mm)
is 1.5X the trace width
please layout 6 mil core and 12 mil trace width
If the RF trace keep 50 ohm characteristic impedance

RF IPEX Connector For External Antenna

Power+WiFi+ CMOS sensor
