OpenNuvoton/NuMaker_NuWicam_RDK/(list of files, drawings)

Other design files:
hardware_design/PCB/NUCAM TVP_162.pcb
hardware_design/PCB/NUCAM VGA_162.pcb
hardware_design/PCB/NUWICAM DEBUG.pcb
hardware_design/SCH/NUWICAM DEBUG 20160607.DSN
hardware_design/SCH/NUWICAM TVP 20160607.DSN
hardware_design/SCH/NUWICAM VGA 20160607.DSN
