OpenNuvoton/NuMaker_NuWicam_RDK/(commit log)

2016-09-08 Add hardware design resources.
    [NUCAM TVP_162.pcb, NUCAM TVP_162.xls, NUCAM VGA_162.pcb, NUCAM VGA_162.xls, NUWICAM DEBUG 20160607.DSN, NUWICAM DEBUG BOM X 100.xls, NUWICAM DEBUG.pcb, NUWICAM DEBUG.xls]
2017-09-04 Fix packet pipe option
    [RTSPServer.c, V4L.c, encoder-jpeg.c]
2017-09-18 Support overlapping on streamed frames.
