OpenNuvoton/NuMaker_NuWicam_RDK/(notices)

Notices in the files:
sources/kernel/kernel_modules/rtl8189FS_linux_v4.3.24.8/core/rtw_mp.c:
under the terms of version 2 of the GNU General Public License as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
sources/kernel/drivers/media/video/w55fa93_hw/sensor_gm7150.c:
the Free Software Foundation; either version 2 of the License, or
(at your option) any later version.
sources/applications/RTSPServer/src/TextOverlap.c:
Free Software Foundation, either version 3 of the License, or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
